MatheusNespolo/DataFlowInventory/docs/fluxogramas/Diagrama elétrico.pptx

Esteira A

TA

J1

MA

GND (0,5 mm)

D0_TA (0,5 mm)

VCC (0,5 mm)

PL_PASS_A

D0_TA

D0_J1

+

IRF520_A

VIN

GND

V+

V-

GND

VCC

SIG

GND (0,5 mm)

5V (0,5 mm)

Fonte 5V

VCC (0,5 mm)

GND (0,5 mm)

D0_TA – A0 (0,5 mm)

Arduino

A

B

RX

TX

D0_J1 (0,5 mm)

D0_J1 – A3 (0,5 mm)

GND

C

C

SIG_IRF520_A – 9 (0,5 mm)

ESP

TX2

RX2

GND

Esteira B

TB

J2

MB

VCC (0,5 mm)

PL_PASS_B

D0_TB

D0_J2

+

5V (0,5 mm)

Fonte 5V

Divisor de tensão

GND (0,5 mm)

D0_TB (0,5 mm)

VCC (0,5 mm)

GND (0,5 mm)

GND (0,5 mm)

D0_TB – A1 (0,5 mm)

D0_J2 – 2 (0,5 mm)

2KΩ

1KΩ

GND

D0_J2 (0,5 mm)

IRF520_B

VIN

GND

V+

V-

GND

VCC

SIG

SIG_IRF520_B – 10 (0,5 mm)

Esteira C

TC

J3

MC

PL_PASS_C

D0_TC

D0_J3

+

5V (0,5 mm)

Fonte 5V

GND (0,5 mm)

D0_TC (0,5 mm)

VCC (0,5 mm)

VCC (0,5 mm)

GND (0,5 mm)

GND (0,5 mm)

D0_TC – A2 (0,5 mm)

D0_J3 – 4 (0,5 mm)

D0_J3 (0,5 mm)

IRF520_C

VIN

GND

V+

V-

GND

VCC

SIG

SIG_IRF520_C – 11 (0,5 mm)

## Slide 2

Legenda

Sigla no esquema elétrico | Descrição/Identificação no sketch principal
TA, TB, TC | Sensor de início das esteiras / SENSOR_TOPO_{A..C}
J1, J2, J3 | Sensor final das esteiras / SENSOR_JUNCAO_J{1..3}
PL_PASS_{A..C} | Placa de conexão dos cabos para os periféricos das esteiras
IRF520_{A..C} | Módulo motor para controle de movimentação
Linhas vermelhas | Cabos de alimentação 5V (bitola de 0,5 mm)
Linhas pretas | Cabos de GND (bitola de 0,5 mm)
Linhas marrons | Sinais generalizados
Linhas laranjas | Comunicação serial
