MatheusNespolo/DataFlowInventory/img/prototipo/prototipo-montado-frente.jpg

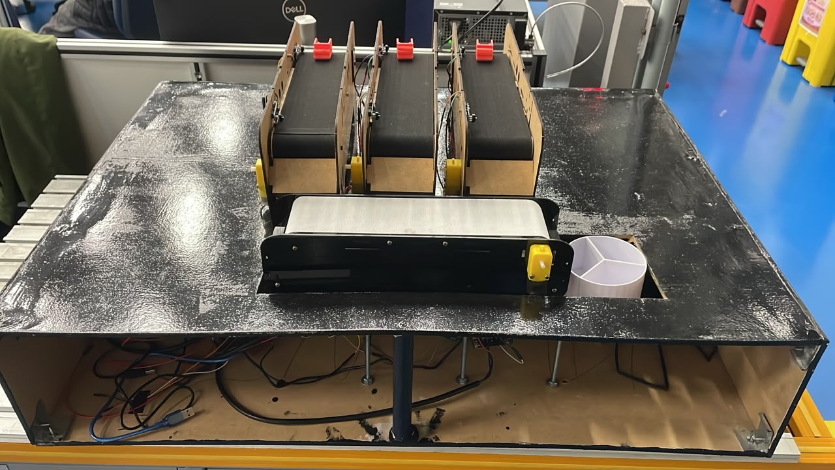
img/prototipo/prototipo-montado-frente.jpg
