MatheusNespolo/DataFlowInventory/img/prototipo/prototipo-montado-superior.jpg

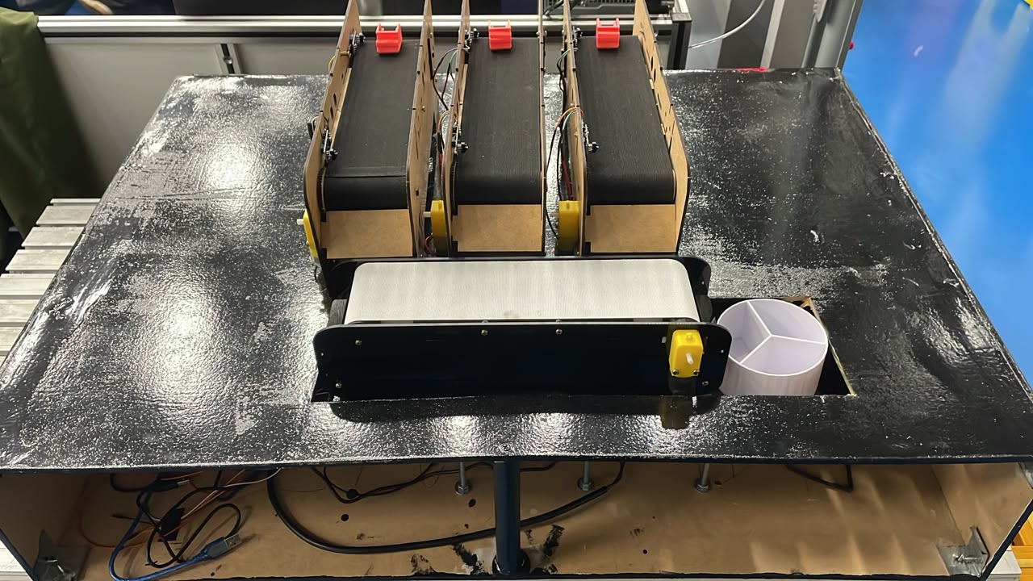
img/prototipo/prototipo-montado-superior.jpg
