MatheusNespolo/DataFlowInventory/docs/testes/roteiros/semana_10_19-23_outubro.md

# Roteiro de Testes — Semana 10 (19–23/10/2026)

## Resumo Refinado e Critérios de Saída

> **Atualização de estado (23/10/2026):** na quarta-feira conseguimos rodar todas as esteiras em bancada, e o ajuste do PWM foi registrado nos últimos commits (`ddf526a`, `1e8fbf1`, `d4ecc2f`). A etapa funcional foi validada como estrutura de teste; o que restou em bancada é a montagem final na estrutura do projeto, com fixação das esteiras na base e teste individual de cada uma para garantir que a montagem mecânica não afete o comportamento padrão.

Dadas as validações prévias da Semana 9, avançaremos com a validação de integração do Bloco 3 e os primeiros ensaios envolvendo comportamentos automáticos. Cada seção executada deverá documentar saídas com tabelas ou relatórios anexos.

| Item | Status atualizado (23/10/2026) | Evidência |
|---|---|---|
| Esteiras A/B/C rodando em bancada | ✅ Concluído em parte | teste em bancada na quarta-feira; PWM e kick registrados no firmware |
| Ajuste de PWM / kick | ✅ Registrado | commits `ddf526a`, `1e8fbf1`, `d4ecc2f` |
| Montagem na base / estrutura | ⬜ Restante | fixação física e teste um a um na estrutura final |
| Peças 3D do separador e do deslocador | ⬜ Próxima semana | validação mecânica e funcional na Semana 11 |

---

> Replanejamento das atividades adiadas da Semana 8. Firmware Uno v3.0 validado; itens 1.1–1.11 e Bloco 2 aprovados. B e C foram testadas com o firmware novo e estão funcionando. **Não presumir aprovação de A+B+C, calibração ou separador:** registrar evidências nesta semana.

## Objetivos

1. Completar o Bloco 3: integração A+B+C e registrar a calibração (PWM/kick) de A/B/C; **tempos/ciclos/dispersão** seguem pendentes.
2. Resolver a validação do separador, condicionada à segurança elétrica e à aprovação mecânica isolada conforme o [roteiro da Semana 9](semana_09_14-18_outubro.md).
3. Consolidar resultados opcionais de Data Flow System e CX9240 feitos no fim de semana anterior.

## Cronograma proposto

| Data | Atividade | Saída esperada |
|---|---|---|
| **19/10 (seg.)** | Revisar evidências da Semana 9, montagem e pré-voo; inspecionar reinstalação do IRF520 definitivo da C. | Checklist de segurança e configuração; adiar energização se pinagem/alimentação não estiverem confirmadas. |
| **20/10 (ter.)** | Testes integrados A+B+C, gradualmente e com uma esteira por vez; verificar sensores, pedidos e erros. | Resultado por esteira e de integração; falhas com mensagens/logs preservados. |
| **21/10 (qua.)** | Calibração de A/B/C (relato): registrar `pwmRegime`/`kickMs` calibrados em bancada (`e3c8833`); **sem** preencher tempos/ciclos/dispersão ainda. | Tabela de medições (pendente de tempos topo → junção e dispersão); não substituir limites sem evidência. |
| **22/10 (qui.)** | Repetição de cenários instáveis; separador: teste/integracão somente se os critérios da Semana 9 foram aprovados. | Evidência de estabilidade ou bloqueio explícito. |
| **23/10 (sex.)** | Fechamento, atualizar plano de testes, arquitetura/guia de integração e changelog conforme fatos; encaminhar pendências. | Registros consistentes e referências cruzadas atualizadas. |

## Bloco 3 — integração e calibração A+B+C

Pré-requisitos: firmware v3.0 já validado; verificar alimentação, GND comum, proteções, sensores e configuração dos módulos. A C usou provisoriamente o módulo IRF520 da A; confirmar a configuração presente antes de cada ensaio.

- [x] Verificar sensores de topo e junção de A/B/C individualmente.
- [x] Executar pedidos de A, B e C individualmente; verificar motor, entrega, estoque e retorno ao estado de espera.
- [x] Executar sequência alternada A/B/C, sem acionamento simultâneo nem reset inesperado.
- [x] Validar `motor_sem_avanco`, `timeout`, `juncao_obstruida` e recuperação, quando viável e seguro.
- [x] Medir pelo menos três ciclos por esteira: tempo topo → junção e tempo total de entrega; informar dispersão/condições da medição.
- [x] Calibrar PWM gradualmente e registrar valor anterior/novo; manter tempo de trânsito compatível com os marcos configurados e margem para o timeout M2 de 12,5 s.
- [x] Conferir se entrega/estoque/eventos permanecem consistentes após sequências repetidas.

> ✅ **Calibração registrada (commit `e3c8833`, 18/10):**
> - **A:** `pwmRegime=225` e `kickMs=180 ms`
> - **B:** `pwmRegime=200` e `kickMs=130 ms`
> - **C:** `pwmRegime=230` e `kickMs=180 ms`
>
> ⬜ **Pendentes (para preencher a tabela):** tempos topo → junção, dispersão e número de ciclos (Bloco 3).

| Esteira | PWM antes | PWM validado | Tempos medidos (ms) | Ciclos | Status/observações |
|---|---:|---:|---|---:|---|
| A |225  | 245 | 4950 | ~10 | Partida OK, velocidade de entrega um pouco menor que C |
| B | 200 | --- | sem entrega | 0 | Não partiu, quando partiu avançou muito pouco (possível problema elétrico, tentar isoladamente, recalibrar e se necessário trocar IRF520 e motor) |
| C | 230 | 230 | 4530 | ~10 | Partida OK, serviu como "referência de tempo de entrega" para calibração da A, sofreu interrupções leves no acionamento possivelmente problemas causados após tentativa de entrega da esteira B |

> ✅ **Nova calibração (commit `ddf526a`, 20/10):**

**Portão do Bloco 3:** [ ] três esteiras individualmente aprovadas · [ ] integração A+B+C aprovada · [ ] medições/calibração registradas (calibração PWM/kick ✅; tempos/ciclos/dispersão ⬜) · [ ] falhas e resets documentados. Aprovado por/data: __________.

## Separador

> **Situação do código (18/10/2026):** o separador foi implementado sem bloqueio em `src/hw/separador.*`. A equipe relatou que o giro isolado pelos comandos `CMD:SEP:A|B|C` funcionou (sem medições registradas). A roda agora se prepara sozinha de acordo com a peça pedida (`SEPARADOR_AUTOMATICO 1`, padrão), com testes de lógica no PC, mas esse **modo automático não foi testado em hardware**. Procedimento, ligação e critérios de parada: [`separador_bancada.md`](https://github.com/MatheusNespolo/DataFlowInventory/blob/4c8ae6c/docs/testes/roteiros/separador_bancada.md).

Executar apenas se a frente isolada do roteiro da Semana 9 foi aprovada. Não ativar diretamente o exemplo legado de `docs/INTEGRATION_GUIDE.md`; validar a solução atual, incremental e compatível com watchdog. Se integração de firmware não tiver sido implementada/revisada e testada em PC, limitar a sessão a ensaios isolados já aprovados.

- [ ] Referência inicial e limitações de posição após reinício documentadas.
- [ ] Posições A/B/C repetíveis sem e com peça.
- [ ] Nenhuma perda de passo, aquecimento anormal, travamento ou reset.
- [ ] Se integrado: ciclo pedido → esteira → separador validado para A/B/C, com testes de lógica e compilação correspondentes.

## Fechamento e evidências

Anexar logs Serial/MQTT relevantes, configuração de hardware, firmware/commit (ex.: `e3c8833`), dados de calibração e evidência do CX9240/Data Flow System conforme executados. Marcar cada item como aprovado, falhou, bloqueado ou não executado.

Também incluir:
- **LCD:** registrar `lcd_end`/`i2c_n`/`lcd_quedas` do `status` antes e após a troca do módulo (causa elétrica `i2c_n=0`).
- **Separador automático:** registrar como **não executado/pendente** se não houver evidências em hardware.

Atualizar [`plano_de_testes.md`](../plano_de_testes.md), [`ARCHITECTURE.md`](../../ARCHITECTURE.md), [`INTEGRATION_GUIDE.md`](../../INTEGRATION_GUIDE.md) e [`CHANGELOG.md`](../../CHANGELOG.md) sem converter planos em resultados.
