MatheusNespolo/DataFlowInventory/docs/testes/roteiros/firmware_uno_v3_validacao.md

# Roteiro — Validação em bancada do firmware do Uno v3.0

> Objetivo: confirmar na bancada o que os testes automatizados não alcançam (sensores, motores, alimentação). Execute na ordem; anote o resultado de cada passo. Firmware: `arduino/data_flow_inventory/` (v3.0). Desconecte o ESP32 dos pinos 0/1 durante o upload no Uno.

> **Execução:** este roteiro é a base dos blocos 1 a 3 do [roteiro da Semana 8](semana_08_05-09_outubro.md), que o aplica esteira por esteira (A, depois A+B, depois A+B+C), com aprovação a cada bloco.

Ferramentas: Serial Monitor (9600 baud) **ou** `test/mqtt_probe` (com o ESP32 conectado) e o dashboard.

> Abrir a Serial Monitor reinicia o Uno (auto-reset da USB) e o estoque volta a 15. Isso é esperado e aparece como `"reset":"reinicio"`.

## 1. Boot

1. Ligue o Uno.
2. **Esperado** (se o Uno já estava ligado e foi reiniciado pela USB, `reset` pode ser `"reinicio"`): a linha `{"type":"evento","evento":"inicio",...,"versao":"3.0",...,"reset":"energia","lcd":true|false,"ram_livre":N}`.
3. Anote `lcd` e `ram_livre`. Se `lcd` for `false`, leia a mensagem `"type":"status"` (sai a cada segundo) e use `lcd_end` e `i2c_n` para localizar o defeito:

| `i2c_n` | `lcd_end` | O que significa | O que fazer |
|---|---|---|---|
| `0` | `0` | Nada responde no barramento | Confira SDA=A4, SCL=A5 (sem inverter), solda dos 4 pinos do módulo, 5 V e GND. Quadrados pretos na 1ª linha com isso = display com energia, mas o módulo I²C não fala com o Uno |
| `1` ou mais | `0` | O barramento está vivo, mas o módulo de LCD não está em 0x20–0x27 nem 0x38–0x3F | O módulo pode ser de outro tipo: rode o scanner de `test/esteira_peca_a/arduino_teste_lcd` e anote o endereço |
| `1` ou mais | `39` (0x27), `63` (0x3F) ou outro | O LCD foi achado nesse endereço | Se o display continuar em branco, ajuste o contraste (trimpot) e o jumper do backlight |

   Se o LCD apagar depois de uma partida de motor, `lcd_quedas` sobe e o firmware tenta religá-lo sozinho em até alguns segundos, com o sistema parado: confira `lcd_end` voltando a um endereço e anote quantas quedas ocorreram por entrega (mais de uma por entrega indica ruído de motor: diodo 1N4007 nos motores, capacitor em paralelo, fios afastados do I²C).

## 2. Sensores (antes de qualquer entrega)

1. Com as três esteiras **vazias**, leia a mensagem `"type":"sensores"`: esperado `"juncao":{"J1":0,"J2":0,"J3":0}`.
2. Passe uma peça sobre cada sensor de junção, um por vez: o valor correspondente deve ir a 1.
3. Repita para os sensores de topo (`"topo"`), com e sem peça.
4. **Se algum sensor ficar sempre em 0 ou sempre em 1**, ajuste o potenciômetro do módulo TCRT5000 (ou a fiação) antes de seguir. Este passo resolve a causa provável da "entrega da B sem débito".

## 3. Uma entrega por esteira (A, B, C)

1. Coloque uma peça no topo da esteira e peça pelo dashboard.
2. **Esperado:** `pedido` → status `ACIONANDO_ESTEIRA` → esteira liga → `entrega` com o estoque daquela peça diminuído em 1 → cerca de 3 s depois da `entrega` a esteira para → status `AGUARDANDO_PEDIDO` (volta ~1,5 s depois).
3. Confira o débito no dashboard e no LCD.

## 4. Motor travado (esteira C)

1. Com uma peça no topo da esteira C (sem ela o erro seria `sem_peca_topo`), segure a esteira C com a mão (ou trave a peça no topo) e peça uma peça C.
2. **Esperado:** em ~3 s, `erro` com `"tipo":"motor_sem_avanco","fase":"partida"`, motor parado, estado `ERRO`, **sem reset do Uno** (nenhum novo `inicio`).
3. Envie Reiniciar no dashboard: volta a `AGUARDANDO_PEDIDO`.

## 5. Timeout no trânsito

1. Peça uma peça e, depois que ela sair do topo, retire-a da esteira antes da junção.
2. **Esperado:** em 12,5 s desde a partida, `erro` com `"tipo":"timeout","fase":"transito"`, motor parado, estoque **intacto**.

## 6. Peça presa na saída

1. Peça uma peça e, quando ela chegar à junção, segure-a sobre o sensor.
2. **Esperado:** `entrega` (débito feito) e, 3 s depois, `erro` com `"tipo":"peca_presa_saida","fase":"saida"`.

## 7. Junção obstruída

1. Com uma peça no topo da esteira, deixe outra peça parada sobre o sensor de junção e peça uma peça daquela esteira.
2. **Esperado:** `erro` com `"tipo":"juncao_obstruida","fase":"verificacao"`, **sem ligar o motor**. Sem peça no topo, o erro publicado é `sem_peca_topo` (a checagem prévia confere estoque, depois topo, depois junção).

## 8. Resistência

1. Faça 10 entregas seguidas (alternando A, B e C).
2. **Esperado:** nenhum `inicio` novo no meio (sem resets) e `ram_livre` do status estável.

## Registro

| Passo | Resultado | Observações |
|---|---|---|
| 1 Boot | | |
| 2 Sensores | | |
| 3 Entregas A/B/C | | |
| 4 Motor travado | | |
| 5 Timeout | | |
| 6 Peça presa | | |
| 7 Junção obstruída | | |
| 8 Resistência | | |
