MatheusNespolo/DataFlowInventory/test/firmware_uno/teste_protocolo.cpp

// Contrato do protocolo serial. As strings "esperado" reproduzem byte a
// byte o que o firmware v2.x (ArduinoJson) publicava: se um destes testes
// quebrar, o ESP32/servidor/dashboard podem deixar de entender o Uno.
#include "protocolo.h"
#include "teste.h"

static char buf[160];  // mesmo tamanho do buffer do firmware (src/hw/comunicacao.cpp)

// ---- Mensagens existentes (formato v2.x, sem campos novos) ----------------

TESTE(status_igual_v2) {
  formatarStatus(buf, sizeof buf, "AGUARDANDO_PEDIDO", 0, 42, -1);
  VERIFICA_TEXTO(buf, "{\"type\":\"status\",\"estado\":\"AGUARDANDO_PEDIDO\",\"pecaSolicitada\":0,\"uptime\":42}");
}

TESTE(estoque_igual_v2) {
  const int est[3] = {15, 14, 0};
  formatarEstoque(buf, sizeof buf, est);
  VERIFICA_TEXTO(buf, "{\"type\":\"estoque\",\"pecaA\":15,\"pecaB\":14,\"pecaC\":0}");
}

TESTE(sensores_igual_v2) {
  const bool topo[3] = {true, false, true};
  const bool jun[3] = {false, true, false};
  formatarSensores(buf, sizeof buf, topo, jun);
  VERIFICA_TEXTO(buf, "{\"type\":\"sensores\",\"topo\":{\"A\":1,\"B\":0,\"C\":1},\"juncao\":{\"J1\":0,\"J2\":1,\"J3\":0}}");
}

TESTE(esteiras_igual_v2) {
  const bool sec[3] = {false, true, false};
  formatarEsteiras(buf, sizeof buf, sec);
  VERIFICA_TEXTO(buf, "{\"type\":\"esteiras\",\"principal\":1,\"secA\":0,\"secB\":1,\"secC\":0}");
}

TESTE(pedido_igual_v2) {
  formatarPedido(buf, sizeof buf, 'B');
  VERIFICA_TEXTO(buf, "{\"type\":\"evento\",\"evento\":\"pedido\",\"peca\":\"B\"}");
}

TESTE(entrega_igual_v2) {
  const int est[3] = {15, 14, 15};
  formatarEntrega(buf, sizeof buf, 'B', est);
  VERIFICA_TEXTO(buf, "{\"type\":\"evento\",\"evento\":\"entrega\",\"peca\":\"B\",\"estoqueA\":15,\"estoqueB\":14,\"estoqueC\":15}");
}

TESTE(erro_igual_v2_com_e_sem_peca) {
  formatarErro(buf, sizeof buf, "ocupado", 'C', nullptr, -1, -1);
  VERIFICA_TEXTO(buf, "{\"type\":\"evento\",\"evento\":\"erro\",\"tipo\":\"ocupado\",\"peca\":\"C\"}");
  formatarErro(buf, sizeof buf, "peca_invalida", 0, nullptr, -1, -1);
  VERIFICA_TEXTO(buf, "{\"type\":\"evento\",\"evento\":\"erro\",\"tipo\":\"peca_invalida\"}");
}

TESTE(inicio_igual_v2_sem_campos_novos) {
  formatarInicio(buf, sizeof buf, "2.1", nullptr, -1, -1);
  VERIFICA_TEXTO(buf, "{\"type\":\"evento\",\"evento\":\"inicio\",\"msg\":\"Sistema iniciado\",\"versao\":\"2.1\",\"driver\":\"IRF520\"}");
}

// ---- Campos novos: sempre DEPOIS dos atuais e só quando informados ---------

TESTE(status_com_ram_livre) {
  formatarStatus(buf, sizeof buf, "ERRO", 2, 4294967295UL, 812);
  VERIFICA_TEXTO(buf, "{\"type\":\"status\",\"estado\":\"ERRO\",\"pecaSolicitada\":2,\"uptime\":4294967295,\"ram_livre\":812}");
}

TESTE(erro_com_diagnostico) {
  formatarErro(buf, sizeof buf, "timeout", 'B', "transito", 12503, 0);
  VERIFICA_TEXTO(buf, "{\"type\":\"evento\",\"evento\":\"erro\",\"tipo\":\"timeout\",\"peca\":\"B\",\"fase\":\"transito\",\"t_ms\":12503,\"bordas_juncao\":0}");
}

TESTE(inicio_com_campos_novos) {
  formatarInicio(buf, sizeof buf, "3.0", "watchdog", 0, 640);
  VERIFICA_TEXTO(buf, "{\"type\":\"evento\",\"evento\":\"inicio\",\"msg\":\"Sistema iniciado\",\"versao\":\"3.0\",\"driver\":\"IRF520\",\"reset\":\"watchdog\",\"lcd\":false,\"ram_livre\":640}");
}

TESTE(maiores_mensagens_cabem_no_buffer_de_160_bytes) {
  const bool t[3] = {true, true, true};
  VERIFICA(formatarSensores(buf, sizeof buf, t, t) > 0);
  VERIFICA(formatarErro(buf, sizeof buf, "peca_presa_saida", 'C', "transito", 2147483647L, 255) > 0);
  VERIFICA(formatarInicio(buf, sizeof buf, "3.0", "reinicio", 1, 2048) > 0);
  VERIFICA(strlen(buf) < 160);
}

TESTE(buffer_pequeno_devolve_zero_e_string_vazia) {
  char pequeno[10];
  VERIFICA(formatarPedido(pequeno, sizeof pequeno, 'A') == 0);
  VERIFICA_TEXTO(pequeno, "");
}

// ---- Comandos -------------------------------------------------------------------

TESTE(comandos_validos) {
  char p;
  VERIFICA(interpretarComando("CMD:PECA:A", &p) == CMD_PECA && p == 'A');
  VERIFICA(interpretarComando("CMD:PECA:C", &p) == CMD_PECA && p == 'C');
  VERIFICA(interpretarComando("  CMD:PECA:B \r", &p) == CMD_PECA && p == 'B');
  VERIFICA(interpretarComando("CMD:RESET", &p) == CMD_RESET && p == 0);
}

TESTE(comandos_invalidos) {
  char p;
  VERIFICA(interpretarComando("", &p) == CMD_NENHUM);
  VERIFICA(interpretarComando("   ", &p) == CMD_NENHUM);
  VERIFICA(interpretarComando("CMD:PECA:", &p) == CMD_PECA_INVALIDA);
  VERIFICA(interpretarComando("CMD:PECA:Z", &p) == CMD_PECA_INVALIDA && p == 0);
  VERIFICA(interpretarComando("CMD:PECA:AB", &p) == CMD_PECA_INVALIDA);
  VERIFICA(interpretarComando("CMD:PECA:a", &p) == CMD_PECA_INVALIDA);
  VERIFICA(interpretarComando("CMD:RESETX", &p) == CMD_DESCONHECIDO);
  VERIFICA(interpretarComando("{\"type\":\"x\"}", &p) == CMD_DESCONHECIDO);
}

TESTE(leitor_monta_linhas_e_ignora_cr) {
  LeitorLinha l;
  leitorIniciar(l);
  const char* entrada = "CMD:PE";
  for (const char* c = entrada; *c; c++) VERIFICA(!leitorAlimentar(l, *c));
  const char* resto = "CA:A\r\n";
  bool pronto = false;
  for (const char* c = resto; *c; c++) pronto = leitorAlimentar(l, *c);
  VERIFICA(pronto);
  VERIFICA_TEXTO(l.buf, "CMD:PECA:A");
}

TESTE(leitor_descarta_linha_longa_inteira) {
  LeitorLinha l;
  leitorIniciar(l);
  for (int i = 0; i < 50; i++) VERIFICA(!leitorAlimentar(l, 'x'));
  VERIFICA(!leitorAlimentar(l, '\n'));  // a linha longa some inteira
  const char* prox = "CMD:RESET\n";
  bool pronto = false;
  for (const char* c = prox; *c; c++) pronto = leitorAlimentar(l, *c);
  VERIFICA(pronto);
  VERIFICA_TEXTO(l.buf, "CMD:RESET");
}

// ---- Diagnóstico do LCD no status ----------------------------------------------

TESTE(status_com_diagnostico_do_lcd) {
  char buf[160];
  formatarStatus(buf, sizeof buf, "AGUARDANDO_PEDIDO", 0, 42, 1097, 39, 1, 0);
  VERIFICA_TEXTO(buf, "{\"type\":\"status\",\"estado\":\"AGUARDANDO_PEDIDO\",\"pecaSolicitada\":0,\"uptime\":42,\"ram_livre\":1097,\"lcd_end\":39,\"i2c_n\":1,\"lcd_quedas\":0}");
  // LCD fora: endereço 0 (campo presente), para o dashboard distinguir de "sem informação".
  formatarStatus(buf, sizeof buf, "ERRO", 2, 7, 900, 0, 0, 3);
  VERIFICA_TEXTO(buf, "{\"type\":\"status\",\"estado\":\"ERRO\",\"pecaSolicitada\":2,\"uptime\":7,\"ram_livre\":900,\"lcd_end\":0,\"i2c_n\":0,\"lcd_quedas\":3}");
}

TESTE(status_sem_campos_do_lcd_continua_igual) {
  char buf[160];
  formatarStatus(buf, sizeof buf, "ERRO", 2, 7, 900);  // chamada antiga: nada muda
  VERIFICA_TEXTO(buf, "{\"type\":\"status\",\"estado\":\"ERRO\",\"pecaSolicitada\":2,\"uptime\":7,\"ram_livre\":900}");
}

// O buffer do Uno tem 160 B e uma mensagem que estoura é DESCARTADA inteira (fim() devolve 0):
// o pior caso do status precisa caber com folga, e o ESP32 lê cada linha num
// StaticJsonDocument<512>.
TESTE(status_pior_caso_cabe_no_buffer_com_folga) {
  char buf[160];
  const size_t n = formatarStatus(buf, sizeof buf, "VERIFICANDO_ESTOQUE", 3, 4294967295UL, 2048, 127, 112, 65535);
  VERIFICA(n > 0);
  VERIFICA(n <= 150);  // folga de 10 B sobre o buffer de 160
}

// ---- Teste de bancada do separador (CMD:SEP, só pela USB) ------------------------

TESTE(comando_separador_aceita_compartimentos_e_neutro) {
  const char letras[] = {'A', 'B', 'C', '0'};
  for (int i = 0; i < 4; i++) {
    char linha[16] = "CMD:SEP:";
    linha[8] = letras[i];
    linha[9] = 0;
    char peca = 0;
    VERIFICA(interpretarComando(linha, &peca) == CMD_SEPARADOR);
    VERIFICA(peca == letras[i]);
  }
  char peca = 0;
  VERIFICA(interpretarComando("  CMD:SEP:B \r", &peca) == CMD_SEPARADOR);  // espaços nas pontas
  VERIFICA(peca == 'B');
}

TESTE(comando_separador_recusa_formas_invalidas) {
  char peca = 'x';
  VERIFICA(interpretarComando("CMD:SEP:Z", &peca) == CMD_DESCONHECIDO);
  VERIFICA(peca == 0);
  VERIFICA(interpretarComando("CMD:SEP:", &peca) == CMD_DESCONHECIDO);
  VERIFICA(interpretarComando("CMD:SEP:AB", &peca) == CMD_DESCONHECIDO);
  VERIFICA(interpretarComando("CMD:SEP:a", &peca) == CMD_DESCONHECIDO);   // minúscula não vale
  VERIFICA(interpretarComando("CMD:SEP", &peca) == CMD_DESCONHECIDO);
  // Os comandos que já existiam não mudam.
  VERIFICA(interpretarComando("CMD:PECA:A", &peca) == CMD_PECA);
  VERIFICA(interpretarComando("CMD:RESET", &peca) == CMD_RESET);
}
