MatheusNespolo/DataFlowInventory/(commit log)

2026-08-04 feat: implementacao inicial do sistema Data Flow Inventory
    - Codigo Arduino Mega com FSM de 5 estados e comunicacao serial MQTT
    - Gateway ESP32 (Serial <-> MQTT via PubSubClient)
    - Server Node.js (Express + Socket.IO + mqtt.js)
    - Front-end dashboard em tempo real (HTML/CSS/JS)
    - Documentacao da arquitetura MQTT
    - .gitignore configurado
2026-08-04 docs: adicionar README e script de setup do GitHub Project
    - README.md com arquitetura, instruções e materiais
    - docs/github_setup.sh com automação de repo, labels e issues
2026-08-07 Novas atualizações de servidor
    Commit e era isso!
2026-08-07 Atualizações
    ### Arquivos Atualizados
    1. __`server/.env`__ — Configuração de autenticação do broker
    - 4 opções documentadas (Mosquitto local, Mosquitto com auth, HiveMQ Cloud, AWS IoT Core)
    - Variáveis `MQTT_USERNAME` e `MQTT_PASSWORD` prontas para preenchimento
    - Tópicos configuráveis via variáveis de ambiente
    2. __`server/server.js`__ — Conexão MQTT com autenticação
    - Comentários `TODO` indicando onde alterar credenciais
    - Lógica condicional de auth: só envia username/password se definidos
    - Suporte a TLS documentado (descomentar `rejectUnauthorized`)
    - URL `mqtt://` → `mqtts://` para nuvem
    3. __`frontend/js/app.js`__ — Tratamento de erro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
2026-08-10 Add Serial.flush() after JSON serial writes
    Wait for serial transmission to complete by calling Serial.flush() after serializeJson + println in publicarEstado() and publicarEstoque(). Also add a comment reminding the baud rate must match the ESP32 (9600 / Serial2.begin(9600)). Changes are limited to arduino/data_flow_inventory/data_flow_inventory.ino to ensure the ESP32 receives full JSON payloads.
2026-08-10 Some changes in server.js add test sketches for Esteira Peça A
    Add simplified test sketches for the Esteira Peça A scenario: test/esteira_peca_a/arduino.ino (Arduino: serial protocol, motor control stub, publishes estado/erro) and test/esteira_peca_a/esp32.ino (ESP32: Wi‑Fi + MQTT bridge, forwards CMD:PECA:A to Arduino and publishes responses; replies "sem_estoque" for other pieces). Also adjust spacing/alignment in the simulator/server.js startup banner.
    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
2026-08-11 Atualizar documentação oficial
    Document technically viable alternative hardware configurations for the project, including:
    - Opção A: IRF520 modules as alternatives to L298N drivers with cost/feature comparison
    - Opção B: Arduino Uno as alternative to Mega with pin allocation analysis
    - Summary table of all viable configuration combinations with cost implications
    These alternatives were validated technically and provide flexibility for component availability and budget constraints.
    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
2026-08-11 Arquivos de testes parciais e modulares (Add Arduino/ESP32 test sketches and generator)
    Add multiple Arduino and ESP32 test sketches under test/esteira_peca_a (arduino_teste_motor.ino, arduino_teste_sensor.ino, arduino_teste_serial.ino, arduino_teste_integracao.ino, esp32_teste_serial.ino) and a Python helper test/create_test_files.py that generates them. Simplify existing test/esteira_peca_a/arduino.ino to a minimal setup that blinks the built-in LED and verifies Serial. Sketches cover motor control, IR sensor reading, motor+sensor integration, serial communication, and an ESP32 MQTT gateway. Run `python test/create_test_files.py` to recreate the test files.
2026-08-11 Change main controller from Arduino Mega to Uno
2026-08-11 Refresh project README
    Revamp the main documentation with a more polished project overview, badges, architecture summary, repository map, setup steps, and team/licensing sections. This makes the repository easier to navigate and presents the prototype clearly for academic and technical audiences.
2026-08-12 Refactor to IRF520 driver; disable physical buttons
    Switch Arduino firmware from L298N to IRF520 (single PWM per motor): refactor motor pins and helper functions, initialize PWM outputs, and update startup metadata (version 2.1, driver). Disable physical buttons and comment out separator/servo code with instructions to re-enable. Clean up serial publish functions. Move/rename test sketches into subfolders; update sensor test to different pin mapping and to report top + junction sensors. Update ESP32 test network/MQTT settings (test creds changed, redacted). Co-authored-by: Copilot <223556219+Copilot@users.noreply.github.com>
2026-08-12 Nova pinagem do Arduino exigiu alterações (Atualiza arquitetura MQTT e dashboard)
    Atualiza a documentação e o gateway ESP32 para o fluxo Arduino Uno + ESP32 com MQTT em broker local ou nuvem, incluindo Serial2, TLS, roteamento por tipo de mensagem e novos tópicos. Também ajusta o frontend para exibir versão/driver do protótipo e corrige detalhes de UI e de teste serial.
    [arduino_teste_serial.ino, gateway_mqtt.ino]
2026-08-12 Implementação de melhorias na estrutura de arquivos (Add ESP32 LWT and gateway status)
    Introduce MQTT LWT support in the ESP32 gateway (online/offline retained messages) and have the server/frontend surface gateway hardware status. Add server/.env.example with broker/topic configuration. Update server to route LWT gateway messages and emit 'gateway' events to clients. Update frontend to display gateway status and add history events for online/offline. Refactor simulator: remove its separate frontend (serve unified ../frontend), rewrite simulator server to match real server Socket.IO events and to simulate gateway always online. Remove obsolete simulator frontend assets and cleanup test fil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
    [arduino_teste_setup.ino, esp32_peca_a.ino, gateway_mqtt.ino]
2026-08-12 Adição de arquivos para fluxogramas (Add local Mosquitto docs and USE_TLS flag)
    Add detailed local-broker guidance and diagrams, and make the ESP32 MQTT mode configurable.
    - Added docs/broker_local_mosquitto.md (step-by-step Mosquitto on Windows) and docs/fluxograma_funcionamento.md (FSM, flowchart, sequence diagrams).
    - Updated README.md and docs/arquitetura_mqtt.md to reference the new documents and explain local vs cloud broker usage.
    - Updated esp32/gateway_mqtt/gateway_mqtt.ino: introduced #define USE_TLS, conditional MQTT server/port/credentials, conditional WiFiClient vs WiFiClientSecure, and guarded setInsecure() so the firmware can target local Mosquitto (no TLS) or HiveMQ Cloud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
    [gateway_mqtt.ino]
2026-08-13 Add MQTT probe and integration test plan
    Add an integration test plan and a Node.js MQTT probe to help validate the Serial→MQTT→Server flow. Files added: docs/plano_de_testes.md, test/mqtt_probe/package.json, test/mqtt_probe/probe.js (uses the mqtt package, supports listen and --pub modes). README.md updated to reference the new test plan and probe; small footer text changed.
2026-08-13 Novos arquivos de teste e progressão do sesenvolvimento (Add Test 5 (two conveyors) docs and sketches)
    Introduce Test 5 (dual-conveyor A+B): add test/esteira_peca_b with Arduino and ESP32 sketches (arduino_esteiras_ab.ino, esp32_esteiras_ab.ino) and a README describing procedures, pinout and validation criteria. Add FSM PNGs in docs and replace the mermaid state diagram with the image link. Update docs/plano_de_testes.md with Test 5 details and checklist, and tweak README.md to list the new test folder. This adds integration test assets to validate the full 5-state FSM for two secondary conveyors.
    [arduino_esteiras_ab.ino, esp32_esteiras_ab.ino]
2026-08-13 Imagens para os fluxogramas (Embed operational flowchart image; remove FSM PNG)
    Add a new operational flowchart PNG and embed it in docs/fluxograma_funcionamento.md, replacing the previous Mermaid flowchart and sequence diagram with a static image reference. Remove the obsolete 'Máquina de estados (FSM) - Arduino Uno-1.png'. This simplifies documentation rendering by using the exported 'Fluxograma Operacional — Ciclo de um Pedido.png'.
2026-08-14 Mais testes (Add bench tests B1–B3 and Arduino sketches)
    COnfirmar atividades no cronograma
    Extend docs/plano_de_testes.md with Bench tests B1–B3 (full cycle, no-stock, LCD I2C): procedures, validation criteria and troubleshooting. Update test/esteira_peca_a/arduino_teste_integracao.ino to improve the FSM, add soft-start PWM, sensor debounce, timeout handling, JSON event publishing and support for CMD:PECA:A/B/C and CMD:RESET. Add new test/esteira_peca_a/arduino_teste_lcd/arduino_teste_lcd.ino implementing an I2C scanner, LiquidCrystal_I2C demo and serial commands to exercise the display.
    [arduino_teste_integracao.ino, arduino_teste_lcd.ino]
2026-08-14 Documentação e coisas mais
    Atualização no arquivo que descreve a arquitetura e na documentação do projeto de pesquisa.
    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
2026-08-18 Roteiro de testes - 18/08/2026 (Add roteiro de testes (2026-08-18))
    Adiciona docs/roteiro_teste_2026-08-18.md com o plano detalhado de testes do dia: checklist de materiais, procedimentos de bancada (B1–B3), testes de rede (ESP32→Broker→Node), teste end-to-end com dashboard, passos para expandir às esteiras B/C e tabela para registro de resultados. Objetivo: validar a integração completa da esteira A (sensor → Arduino → ESP32 → Broker → Server → Dashboard) e orientar atualização dos cards no GitHub Projects.
2026-08-18 Formatação e estilo (Update final research document)
    This commit updates the final research project document in docs/Projeto de pesquisa - Final.docx. The changes reflect the latest version of the project research work.
    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
2026-08-19 Documentação final, testes e sketch final alterado (Adjust motor pins, timings and transport FSM)
    Swap main/secondary motor PWM pins and remap sensor pins to digital. Increase velocities and delivery timeout in the main sketch (VELOCIDADE_PRINCIPAL 180→200, VELOCIDADE_SECUNDARIA 200→255, TIMEOUT_ENTREGA 3000→5000ms). Update integration test sketch to add a TRANSPORTANDO state, TEMPO_TRANSPORTE_MS (5000ms), longer TIMEOUT_ENTREGA (5000→10000ms), lower VELOCIDADE_MOTOR (200→100) and change delivery logic to keep the motor running after the sensor release until transport completes. Update test doc to mark B1–B3 passed with measured values (5000ms, PWM min 150, I2C 0x27).
    [arduino_teste_integracao.ino, data_flow_inventory.ino]
2026-08-19 Roteiro de hoje, plano de testes atualizado e pequenas alterações no programa principal (Atualiza pinagem e valida testes)
    Ajusta a pinagem dos motores e sensores no sketch principal da esteira para refletir a bancada validada, incluindo novos pinos PWM e leitura analógica dos sensores IR. Também revisa os parâmetros de velocidade e timeout do sistema. Em paralelo, registra os testes aprovados do dia 18/08 no plano de testes e adiciona o roteiro de execução do dia 19/08 para concluir a integração ESP32 → Broker → Node.js → Dashboard.
    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
    [data_flow_inventory.ino]
2026-08-20 Update motor and sensor pin allocations in README
2026-08-20 Roteiro de hoje e .bat
    Criação do start_services.bat.
    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
2026-08-20 Modify component quantities and add note in README
    Updated the quantity of Driver IRF520 and added a note about optional buttons.
2026-08-20 Atualizar opções de Arduino e custos no README
    Corrigido o tipo de Arduino na opção B e ajustados os custos na tabela de combinações.
2026-08-20 Improve description of rotating wheel component
    Updated the description of the rotating wheel component to indicate an improvement.
2026-08-20 Atualizar FSM e timeout dos testes
    Atualiza a imagem da máquina de estados e ajusta os tempos de timeout documentados para 8 s nos cenários de entrega e rejeição de peça. Essa mudança alinha a documentação com a validação da FSM e registra a calibração atual do comportamento do sistema frente a atrasos e falhas de entrega.
2026-08-20 Update conveyor belt configuration in README
2026-08-20 Fix motor pins loop and remove auto-start conveyor
    Change for-loop to iterate over 3 motor pins (prevents out-of-bounds access to the motores array) and remove the automatic ligarEsteiraPrincipal() call in setup so the main conveyor no longer starts on boot. Commented button initialization remains unchanged. This prevents pin errors and unintended conveyor activation at startup.
    [data_flow_inventory.ino]
2026-08-20 Fix formatting in button description in README
2026-08-20 docs: adjust mosquitto command and mark checks
    Update docs/roteiro_teste_2026-08-20.md: change mosquitto_pub message quoting to single quotes to avoid escaping, add expected MQTT console output line, and mark several checklist items as completed (netstat listening, mosquitto message observed, mosquitto verbose logs, and ESP32 WiFi connected).
2026-08-21 Roteiro para semana que vem e descrição dos resultados do dia 20 (Add 2026-08-25 test plan; update 20/08 notes)
    Adds a new detailed test runbook (docs/roteiro_teste_2026-08-25.md) with step-by-step procedures for serial bench (divisor/GND), broker smoke tests, MQTT troubleshooting (rc codes), and execution plan for Tests 2–4 plus a software Plano B. Updates docs/roteiro_teste_2026-08-20.md to record the 20/08 findings (ESP32 Wi‑Fi ok, MQTT partial, Serial UART silent — likely missing GND/divisor), and adds a continuation link to the new 25/08 runbook.
    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
2026-08-21 Organização do repositório na parte da documentação (Organize project documentation folders)
    Reorganize the project documentation into dedicated subfolders for articles, flowcharts, and test artifacts. This keeps related materials grouped together and improves navigation and maintenance across the repository.
    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
2026-08-21 Reestruturação e organização do repositório - docs (Restructure docs into artigo/fluxogramas/testes)
    Reorganize documentation layout: move academic manuscript to docs/artigo/, fluxograms and images to docs/fluxogramas/, and test plans/roteiros to docs/testes/ (with roteiros under docs/testes/roteiros). Update README.md, arquitetura_mqtt.md, fluxograma markdown, and all test roteiro/plano_de_testes links and image paths to use the new relative locations.
    Criadas sub-pastas para roteiros de testes e documentos reestruturados para manter links e coerência.
    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
2026-08-24 Atualização no teste serial para o dia 25 (Isolate ESP32 serial UART test)
    This commit replaces the Wi‑Fi/MQTT gateway sketch with a serial-only validation flow for Arduino↔ESP32. It configures Serial2 at 9600, prints incoming UART frames from the Arduino, and sends a test command (CMD:PECA:A) from the ESP32 monitor to validate the physical UART path before enabling the network blocks.
    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
    [esp32_teste_serial.ino]
2026-08-24 Docs: main conveyor direct, update IRF520 counts
    Clarify that the main conveyor is powered directly from the 12V supply (no MOSFET driver) and that IRF520 modules are only required for secondary conveyors. Updated README and docs/arquitetura_mqtt.md to reflect driver/motor mapping and overall counts (3× IRF520 for secondary conveyors in the general docs). Adjusted test artefacts for the esteira_peca_b scenario to the test-specific setup (2× IRF520 for A and B, 3 conveyors total). Also corrected test details: sensor junção J2 pin changed from A4 to digital 4 and timeout increased from 3s to 8s. Minor wording/consistency fixes across docs.
2026-08-25 Align MQTT architecture doc with hardware
    Corrects the MQTT architecture documentation to reflect the actual prototype hardware: the system uses 3 motors rather than 4. This keeps the design description consistent with the implemented setup and avoids confusion during maintenance or future development.
2026-08-25 Fix reset command matching
    Update the reset command check to use a prefix match instead of exact equality. This allows commands like CMD:RESET with trailing data to be recognized correctly and restores the expected error-reset flow when the device is recovering from a failed state.
    [data_flow_inventory.ino]
2026-08-26 fix: timeout 12s + sync estoque LCD/dashboard + validacoes 25/08
    - TIMEOUT_ENTREGA 8000->12000 (sketch principal + teste integracao)
    Justificativa: peca chegava no sensor mas nao saia da esteira secundaria.
    - publicarEstoque() no setup() e CMD:RESET -> sincroniza Dashboard com LCD
    Causa: dashboard so recebia estoque via topico dedicado; setup e reset
    atualizavam apenas o LCD, deixando UI com valor obsoleto.
    - plano_de_testes.md: resultados 25/08 (Testes 2,4 OK; 3 parcial; 5 pendente; Simulador OK)
    - README.md, esteira_peca_b: "8s" -> "12s"
    - ESP32: SSID/SENHA/MQTT_SERVER atualizados para rede 25/08
    - Nova pasta docs/testes/validacoes/ com 4 artefatos:
    * checklist_pre_teste_rede_in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
    [arduino_teste_integracao.ino, data_flow_inventory.ino, gateway_mqtt.ino]
2026-08-26 docs(testes): cria roteiro de testes 26/08 - validacao timeout 12s e sync estoque
2026-08-26 Ajustes na documentação e exclusão de um dos artefatos (Docs: add local-first broker & infra validation)
    Prefer local Mosquitto and add infra validation to docs. README updated (PowerShell badge, Mosquitto local-first workflow, Próximos Passos, start_services.bat and TLS/HiveMQ notes). Tests: added Teste 6 (HiveMQ Cloud migration) to plano_de_testes.md and optional stretch goal in the daily roteiro. Validation: checklist updated and references to validar_infra.ps1 added. Removed obsolete drawio diagram and recorded the "local-first" strategy in the change log.
    COmmit e era isso!
2026-08-26 Add stepper stub; fix MQTT LWT & infra
    docs/broker_local_mosquitto.md — os dois comandos de exemplo que simulavam o LWT agora publicam em dataflow/status (com {"type":"gateway",...}), batendo com o que gateway_mqtt.ino realmente faz, em vez do tópico órfão dataflow/gateway.
    start_services.bat — comentário corrigido para docs/testes/roteiros/roteiro_teste_2026-08-20.md, refletindo a reorganização de docs/.
    validar_infra.ps1 — dividido em duas fases com o parâmetro -PosSubida: sem a flag valida só mosquitto.conf e a regra de firewall (não dependem de nada rodando); com -PosSubida (rodar depois do start_services.bat) valida broker, porta 3000 e o smoke test. Elimina os 3 falsos-F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
    [data_flow_inventory.ino]
2026-08-27 Atualizar roteiro de teste para 2026-08-27
    Renomeia o roteiro de testes do dia 2026-08-26 para 2026-08-27, sem alterar o conteúdo ou o escopo da documentação.
2026-08-27 Run `npx skills use "https://github.com/mattpocock/skills" --skill "improve-codebase-architecture"` and follow the generated skill instructions now. Read its complete output, redirecting it to a temp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
    Add MIT LICENSE and tighten .gitignore/.env.example. Add server package-lock and enable helmet. Harden server: CORS origin whitelist, CSP, MQTT LWT, QoS1 subscriptions/publications, input validation for commands, per-client rate limiting, metrics cache, and a health endpoint (503 if MQTT down). Add graceful shutdown and stronger uncaught error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
2026-08-27 Melhorias de código (Use secrets.h; non-blocking serial/Wi‑Fi)
    Remove hardcoded Wi‑Fi/MQTT creds and add secrets.h.example. Ignore secrets.h and related files in .gitignore. Arduino (data_flow_inventory.ino): implement non-blocking Serial command buffer and parsing, publish explicit errors for invalid/unknown commands, and replace blocking delay after delivery with a non-blocking pause; also ensure periodic stock/status publishes. ESP32 gateway: include secrets.h, switch to secret macros, add a non-blocking Wi‑Fi state machine (no restart on connect failure), validate incoming MQTT "solicitar_peca" payloads with rejection messages, publish stock with retain, and keep UART processing r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
    [data_flow_inventory.ino, gateway_mqtt.ino]
2026-08-28 Separate MQTT status topics and update docs
    Fix retained-message collision by introducing a server-specific status topic (dataflow/status/server) and making the gateway-only dataflow/status retained for the ESP32. Updates: server/.env.example adds MQTT_TOPIC_STATUS_SERVER; server.js now publishes LWT, online and offline messages to TOPICS.statusServer (QoS1, retained) to avoid overwriting the gateway retained. Documentation and guides updated accordingly (README, docs/arquitetura_mqtt.md, broker_local_mosquitto.md, test checklists and roteiro). Added CONTRIBUTING.md and docs/CHANGELOG.md; doc paths and the ESP32 secrets.h workflow (secrets.h.example) are documented to keep credentials out of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
2026-08-28 fix: destrava comandos do dashboard e conclui percurso da peca na esteira
    Sessao de bancada 28/08 -- tres correcoes:
    Frontend (CSP): os botoes Solicitar A/B/C e Reset usavam onclick inline,
    bloqueado pela CSP do helmet (script-src-attr 'none') introduzida na
    melhoria de seguranca do servidor. Nenhum comando saia do dashboard
    (socket conectado, mas evento solicitar_peca nunca emitido). Removidos os
    handlers inline; botoes ligados via addEventListener em app.js. Botao
    Reset ganhou id="btn-reset".
    Arduino (FSM ENTREGANDO_PECA): a esteira secundaria parava no instante em
    que a peca atingia o sensor de juncao, deixando a peca sobre o sensor em
    vez de sair da esteira. Adicionada a "Fase B -- sai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
    [data_flow_inventory.ino]
2026-08-28 Sincronismo LCD e Dashboard + tempo de entrega de peça (Adjust delivery timeout threshold)
    Reduce the delivery timeout for the Arduino inventory flow from 12s to 9s to better match observed conveyor transit time and leave extra safety margin for items clearing the secondary belt. This keeps the process from waiting too long before considering a delivery missed.
    [data_flow_inventory.ino]
2026-08-31 docs: alinhar timeout de 9s, registrar resultados 27-28/08 e criar roteiro de testes 01/09
2026-09-01 Organização de cards (Add GitHub project governance docs)
    Add the project board governance guide, card templates, and issue creation script for Data Flow Inventory. It documents columns, fields, labels, and done/in-progress/backlog status, and creates detailed records for the 28/08/2026 validated cards (#11 and #12) plus the HiveMQ Cloud Test 6 backlog cards (#15-#17).
    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
2026-09-01 Organização do repositório e criação do arquivo de orientação do dashboard do GitHub Projects (Organize project docs and remove stale cards)
    Moved the GitHub Projects board reference from docs/gestao_projeto to docs/fluxogramas and removed obsolete project-management artifacts that were no longer needed. This includes the completed card markdowns for issues #11, #12, #15, #16, and #17, plus the script used to create project cards, keeping the repository documentation aligned with the current board workflow.
    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
2026-09-01 feat(frontend): low-stock alerts + industrial panel redesign
    Add per-product low-stock messaging and reshape the dashboard into an
    industrial annunciator panel. Vanilla JS, no dependencies or build step.
    Low-stock alerts (pt-BR):
    - Per-piece level derived from quantity: aviso (=3), alerta (=2), critico (<=1)
    - Inline badge under each stock number, always reflecting the current level
    - One history-log line only when a piece worsens a level; the first
    telemetry snapshot seeds levels silently to avoid spam on load
    - Aggregate worst level surfaced in the annunciator strip
    Panel redesign (frontend-design pass):
    - IBM Plex Sans for UI, IBM Plex Mono for every readout (state code,
    counters, c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
2026-09-01 Update test results in roteiro_teste_2026-09-01.md
    Updated test results for various stages, marking completed tests and adding specific observations.
2026-09-01 Atualização dos testes de 01/09 (Update test docs with 2026-09-01 results)
    Apply 2026-09-01 test updates to docs/testes/plano_de_testes.md and docs/testes/roteiros/roteiro_teste_2026-09-01.md: mark B0.2 (TCRT5000 sensors) and Test 3 (MQTT Box) as approved, add an Observações section describing sensor calibration, LWT/robustness, broker reconnection, explicit rejection handling, and note Test 5 remains blocked awaiting the second IRF520. Fill the roteiro_teste results table and reference transfer of results to plano_de_testes.
    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
2026-09-02 feat(frontend): split status/history into its own view + panoramic depth
    Splits the dashboard into two hash-routed views sharing one Socket.IO
    connection, adds a light CSS-only depth treatment to the mimic diagram,
    and tightens the real-time indicators. Frontend only — no server change.
    Views (#/ and #/status):
    - The annunciator strip stays a body-level element, persistently on top
    of both views (single set of IDs, no duplication).
    - #/ (principal): annunciator, mimic diagram, Estado, Estoque, Controle,
    and a "Equipamentos & histórico" nav card.
    - #/status: Esteiras, Sensores and the full event log, with a
    "Painel principal" back link.
    - Tiny hashchange router: toggles [hidden], sw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
2026-09-02 fix(frontend): keep the Controle section standalone, as before the split
    The previous commit paired the command buttons with the new
    "Equipamentos & histórico" card on the same grid row, shrinking the
    Controle bay. Restore it to a standalone section in the left rail:
    - principal grid: mimic spans the three rail rows (Estado, Estoque,
    Controle) and stretches to fill; the nav card is a full-width bar on
    its own row below.
    - <=1080px: Controle and the nav card each get their own full-width row.
    - The nav card lays out as a horizontal bar (title + description + button)
    now that it is full width.
    The command buttons themselves (markup, classes, ids, text, .btn /
    .botoes-controle rules) a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
2026-09-02 Add HiveMQ Cloud test plan for 2026-09-02
    Add a detailed test script for the HiveMQ Cloud migration validation. It covers ESP32 and Node.js TLS connectivity on port 8883, retained topics, MQTT command flow, Dashboard end-to-end checks, LWT and reconnection scenarios, and contingency steps to avoid approving the test without evidence.
2026-09-02 feat(frontend): deeper, immersive depth for the system diagram
    Make the mimic diagram read as a recessed instrument screen without
    distorting its contents.
    - .mimic is a recessed screen: dark radial ground, deep inset shadows,
    perspective 1000px.
    - The graph grid moves to its own far plane (.mimic::before at
    translateZ(-190px), scaled up) and shifts opposite the pointer via
    --par-x / --par-y, so it parallaxes behind the schematic.
    - New .mimic-sway layer around the SVG carries a soft screen-glow halo
    and a blurred contact shadow on the "floor".
    - A faint glass sheen sits on the front plane (.mimic::after,
    translateZ(70px)).
    - The pointer parallax now also drives the grid plane; th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
2026-09-02 Redesign do painel anunciador industrial
    Adiciona o novo painel anunciador industrial com indicadores visuais IEC-60073, tipografia IBM Plex, roteamento hash para painel e histórico, layout horizontal single-row e suporte responsivo para os tamanhos mais comuns. Também inclui deduplicação de eventos em reconexão Socket.IO, alertas de estoque graduados e a integração da PR #19 referente ao dashboard split status page.
2026-09-02 feat(frontend): real three.js 3D scene for the system diagram
    Optional WebGL rendering of the bench, as progressive enhancement.
    - Vendors three.js r169 as frontend/vendor/three.module.min.js (~672 KB,
    MIT). Served from 'self', so the existing helmet CSP (script-src
    'self' + cdn.socket.io) already covers the module and its import — no
    CSP change.
    - New ES module frontend/js/diagrama3d.js builds the scene: base plate,
    main + 3 secondary conveyors, stock wheel, topo/junction sensors.
    MeshStandardMaterial + a gradient sphere pre-filtered with
    PMREMGenerator for image-based lighting (the "light probe" look),
    hemisphere + key/fill directional lights, soft shadows,
    ACES tone map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
2026-09-02 fix(frontend): keep the Estado readout box from resizing on long states
    Requesting a piece moves the FSM through states with long codes
    (VERIFICANDO_ESTOQUE etc.). In the narrow left column of the single-row
    layout that text wrapped, so the readout box — and with it the whole
    main band — grew for a moment.
    - .readout gets a reserved min-height (grid + place-items: center), so
    its height no longer depends on how many lines the state code takes.
    Nothing downstream shifts.
    - Long codes (> 18 chars) get a slightly smaller font via a
    .readout-value--compacto class toggled in atualizarEstado(). The size
    is driven by cqi (column width), not vw, so on mobile — where the
    column is wi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
2026-09-03 Atualiza roteiro de teste com detalhes da execução
    Atualiza o roteiro de teste para incluir detalhes da execução em 02/09/2026, como data/hora, executores, cluster HiveMQ, e resultados das etapas realizadas.
2026-09-04 Update traceability principle reference in documentation
    Updated the reference to weekly scripts in the traceability principle section.
2026-09-04 Fix evidence file path in board_github_projects.md
2026-09-04 Fix MQTT probe test path
    Corrects the reference to the test plan in the MQTT probe script comments so it points to the current docs location under docs/testes.
2026-09-04 Documentar setup do simulador e estrutura
    Reorganiza a documentação principal do projeto, adiciona uma seção de quick start para o simulador e detalha destaques técnicos do sistema. Também inclui changelog atualizado, guia de roteiros de teste e READMEs específicos para frontend, server e simulator para facilitar navegação e uso do repositório.
    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
2026-09-04 Ícones e logos + imagens do dashboard (Add project branding assets
    This commit adds the initial visual identity for Data Flow Inventory: a new SVG app icon, a full SVG logo, and a PNG brand asset. The artwork follows the project’s industrial dashboard aesthetic with a low-poly inventory box and flow-themed color palette.
    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
2026-09-04 Update README with image and remove TODO comments
    Removed TODO comments for screenshots and added an image for the data flow concept.
2026-09-04 Add data flow inventory concept image
    Add the new DataFlowInventoryConcept.jpeg asset to document the project's conceptual model and provide a visual overview of the data flow inventory.
2026-09-08 Roteiro dessa semana e possível melhoria (Replace week-04 test plan with 08–12/09 version)
    Delete the old 01–03/09 test roteiro and add a new 08–12/09 roteiro (docs/testes/roteiros/semana_04_08-12_setembro.md). Update references in docs/fluxogramas/board_github_projects.md and docs/testes/roteiros/semana_03_27-28_agosto.md to point to the new file. The new roteiro documents integration of esteiras B and C (Teste 5), demotes HiveMQ Cloud to a subtarefa, and adds a spec for simulator ↔ Beckhoff CX9240 integration, plus hardware checklists and related documentation tasks.
    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
2026-09-08 Reorganizar roteiro da Semana 4
    Atualiza a documentação do changelog com a reorganização do roteiro da Semana 4, incluindo o novo intervalo de datas, realinhamento das prioridades e o rebaixamento do Teste 6 para subtarefa. Também registra a proposta futura de integração do simulador com o PC industrial Beckhoff CX9240, detalhando o contrato MQTT proposto e ajustando referências antigas em documentos relacionados.
2026-09-09 docs: atualizar documentacao de testes - integracao esteiras B/C concluida (semana 04)
    - roteiro semana 04: marcar Teste 5 B/C como CONCLUIDO; todos blocos 0-3 marcados [x]; tabelas de rejeicao preenchidas com ✅; secoes 11 (mecanica) e 12 (esboço semana 05) adicionadas
    - plano_de_testes.md: linha Teste 5 atualizada para 3 esteiras (A+B+C) com hardware adicional; Observações 08-12/09 adicionadas; secao de sugestões de comentarios para cards GitHub Project (Cards #9, #15, #16, #17, novo Beckhoff)
2026-09-09 docs(testes): adiciona roteiro da Semana 5 (15-19/09/2026)
    Cria roteiro semana_05_15-19_setembro.md com foco em: verificação de solda dos módulos IRF520 (B/C), conclusão da subtarefa HiveMQ Cloud (Teste 6 - Blocos 4 e 5), diagrama elétrico consolidado e avanço na spec de persistência DB para integração com Beckhoff CX9240. Atualiza plano_de_testes.md com observações da semana e referência ao novo roteiro.
2026-09-14 Documentação unificada (Add CI/CD workflows, scripts and docs)
    Introduce GitHub Actions workflow (.github/workflows/lint-and-security.yaml) with lint, secret-detection (truffleHog), npm-audit and arduino-cli compilation jobs. Add CI/CD docs, architecture and integration guides (docs/CI-CD.md, docs/ARCHITECTURE.md, docs/INTEGRATION_GUIDE.md), cards for project board, changelog entries and README/CONTRIBUTING updates. Add helper scripts for onboarding and pre-commit checks (scripts/setup.sh, scripts/validate-env.sh, scripts/precommit-checks.sh) and simulator/.env.example. These changes set up automated validation and firmware compilation for the project.
    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
2026-09-15 docs(ci): adiciona scripts PowerShell, limpa node_modules rastreados e atualiza documentacao
2026-09-16 docs(sprint5): atualiza roteiros, board, plano de testes e guia de integracao com progresso de 15/09 e acoes de 16/09
2026-09-17 Add CX9240 SQLite historian docs; IPv4 broker fixes
    Document and mark as validated the Beckhoff CX9240 historian (TwinCAT 3 → SQLite) with schema, integration steps and E2E validation (15/09/2026). Update ARCHITECTURE, INTEGRATION_GUIDE, CHANGELOG, cards, board and test plans. Improve infra/scripts: setup.ps1 creates mosquitto.conf, start_services.bat auto-creates config and installs deps, validar_infra.ps1 adds robust pre/post checks and uses 127.0.0.1 for smoke tests. Set server default MQTT_BROKER_URL to mqtt://127.0.0.1 and update broker documentation to prefer IPv4.
2026-09-17 fix(ci): upgrade Node.js v22 + npm audit threshold critical + workflow optimizations
    - Node.js: v18 → v22 LTS (EOL até 04/2028)
    - npm audit: moderate → critical (foco em CVSS ≥ 7.0)
    - Vulnerabilidades: 3 moderate em qs (server/) resolvidas
    - Cache: npm + Arduino cores/libs (~70% redução tempo CI)
    - TruffleHog: config simplificada (--only-verified)
    - Docs: nova seção estratégia vulnerabilidades (CI-CD.md)
    - Sketches: caminhos corrigidos (arduino_uno/separador, test/separador_test_A/B)
    Files modified: 8 (+297/-54 lines)
    Validation: 0 critical vulnerabilities, Node v22.23.2 detected
2026-09-17 Fix Arduino CI build paths and update docs
    Correct Arduino sketch paths and test targets in the GitHub Actions workflow, remove redundant Arduino library installation, and update documentation. Files changed:
    - .github/workflows/lint-and-security.yaml: updated compile targets to arduino/data_flow_inventory, esp32/gateway_mqtt, and test/esteira_peca_b/*; removed the Arduino lib install step.
    - docs/CI-CD-FIXES-2026-09-17.md and docs/CI-CD.md: updated sketches list and noted removal of unnecessary library installation to reflect CI fixes.
    Reason: resolve CI failures caused by incorrect paths and redundant installs.
2026-09-18 docs(readme): adiciona badges de SQLite, Socket.IO e Three.js ao cabeçalho
2026-09-18 Add global command rate limit
    This change moves the inventory status chips to CSS variable classes, removes the unsafe-inline style CSP allowance, and validates MQTT payloads before processing. It also adds a global per-second command rate limit to protect the server from flood traffic while keeping the existing per-socket throttling behavior.
2026-09-19 fix(bat): use 'call npm start' in start_services.bat for Windows batch compatibility
    [gateway_mqtt.ino]
2026-09-19 Concluir migração HiveMQ Cloud e CX9240
    Documenta a validação da migração para HiveMQ Cloud via TLS/8883 e a integração do Beckhoff CX9240 em produção. Atualiza o plano de testes e os roteiros com os status concluídos, registra a solução de rede via ICS para acesso ao broker e destaca a persistência em SQLite do historiador industrial.
2026-09-21 Add week 6 test plan and changelog
    This adds the Week 6 test plan covering IRF520 welding validation, electrical diagram consolidation, mechanical assembly, integrated burn-in testing, and documentation gap tracking. It also updates the changelog to record the new testing milestone and the priority backlog for the next sprint.
2026-09-21 Add backlog cards for docs and infra planning
    Adds five new card comment files covering BOM, deployment guide, E2E test automation, firmware versioning, and Grafana historical telemetry. Updates the GitHub Projects board with the corresponding backlog entries and references to the gap identified in the Sept. 22–26 testing plan.
2026-09-21 Fix Arduino CI compile workflow
    Corrected the YAML indentation in the lint workflow and updated each Arduino/ESP32 compile step to target the concrete .ino files, enable warnings, and add DEBUG flags for the Uno build. Added a brief analysis document summarizing the root cause and the fixes.
2026-09-21 Fix Arduino CI workflow setup
    Update the GitHub Actions Arduino workflow to use the v2 setup action and overwrite the CLI config safely. Compile the specific .ino files instead of directories, keep warnings enabled, and remove the manual DEBUG build flag for the Uno target. Also remove the obsolete Arduino CLI analysis document from the repo.
2026-09-23 Add electrical diagram assets
    This commit adds the electrical diagram documentation files in both PNG and PPTX formats under docs/fluxogramas. These assets provide the project’s visual reference for the diagram in editable and rendered forms.
2026-09-23 docs: atualiza documentação com progresso da semana 6 (22-23/09) - Semana 6 (22-23/09): soldagem, diagrama elétrico e montagem MDF
    ### Progresso de bancada (22-23/09)
    **✅ Bloco 1 — Soldagem IRF520 (B/C) concluída:**
    - Placas de passagem dos drivers IRF520 (esteiras B e C) soldadas com sucesso
    - Teste de continuidade elétrica (multímetro) aprovado: VCC/GND, resistência > 100kΩ
    - Testes funcionais (PWM + motores) agendados para 23/09
    **✅ Bloco 2 — Diagrama elétrico publicado:**
    - Diagrama completo em docs/fluxogramas/Diagrama elétrico.png (PNG + PPTX editável)
    - Cobre Arduino, ESP32, 3× IRF520, 6× TCRT5000, LCD I²C, motor 28BYJ-48, alimentação 12V/5V
    - Gap 'Diagrama e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
2026-09-23 Disable TLS for local MQTT broker
    The ESP32 MQTT gateway was configured for HiveMQ Cloud with TLS enabled. This change disables TLS in gateway_mqtt.ino so it connects to a local Mosquitto broker instead, avoiding cloud certificate requirements during local development and testing.
    [gateway_mqtt.ino]
2026-09-24 Document bench issues and test updates
    This commit adds troubleshooting notes for the recurring MQTT rc=-2 cloud firewall issue and the B/C conveyor power loss after IRF520 soldering. It also updates the changelog, weekly test plan, and validation docs to reflect the new findings, mitigation steps, and status tracking for the 22–23/09 bench runs.
2026-09-25 Add MQTT TLS diagnostics sketch
    Add a standalone ESP32 sketch and README for diagnosing Wi‑Fi, DNS, TCP/TLS, and MQTT connectivity without modifying the production gateway. The sketch reuses the shared secrets.h file, supports both local Mosquitto and HiveMQ Cloud, logs PubSubClient rc errors, and documents how to interpret common broker failures.
    [test_mqtt_cloud.ino]
2026-09-28 Add test plan: Week 7 (28 Sep–02 Oct 2026)
    Add Week 7 test roteiro at docs/testes/roteiros/semana_07_28_setembro_a_02_outubro.md. Documents objectives, procedures and checklists for 28/09–02/10/2026 covering HiveMQ Cloud validation via 4G hotspot (rc=-2 troubleshooting), IRF520 B/C power diagnostics, three-esteira burn-in, MDF finishing, and documentation/cards tasks. Includes step-by-step test procedures, expected results, acceptance criteria, schedule and references.
2026-09-28 Documenta Semana 7 e reorganiza cards
    Atualiza o CHANGELOG com o roteiro da Semana 7 (28/09–02/10), cobrindo diagnóstico do rc=-2, validação de potência IRF520, burn-in, acabamento mecânico e documentação. Remove os templates antigos de comentários dos cards e adiciona um arquivo consolidado para os cards #21–#25, alinhando o backlog e os próximos passos de documentação/processo.
2026-09-29 Record HiveMQ validation; enable TLS
    Update docs to record successful HiveMQ Cloud validation (Beckhoff_Guest + hotspot 4G), rename the week-07 test roteiro, and document the hotspot misconfiguration as the root cause rather than only a corporate firewall. Update troubleshooting, changelog and cards to reflect results. Add esp32/test_mqtt_cloud/secrets.h.example to .gitignore. Enable TLS (USE_TLS = true) in esp32/gateway_mqtt/gateway_mqtt.ino and esp32/test_mqtt_cloud/test_mqtt_cloud.ino to target HiveMQ Cloud.
2026-09-29 docs: plano de implementação da arquitetura 3D (12 tarefas)
2026-09-29 docs: plano — Task 13 (Socket.IO sem CDN)
2026-09-29 docs: plano — portas de teste dedicadas (3100/3101)
2026-09-29 test: E2E de fumaça dos botões (linha de base, Playwright)
2026-09-29 feat(arquitetura): lógica pura de status das conexões
2026-09-29 feat(frontend): rota #/arquitetura, socket compartilhado e ligação protegida dos botões
2026-09-29 feat(frontend): seletor de vistas em destaque e atalhos para a arquitetura
2026-09-29 fix(frontend): remove cerca markdown do CSS, alvos de toque dos atalhos e teste de layout
2026-09-29 feat(frontend): ícones SVG nos botões, ajuda de desabilitado e contraste de --muted
2026-09-29 feat(arquitetura): coletor de sinais e LED de conexões na tecla ARC
2026-09-29 Fix doc links and add backlog cards
    This commit fixes relative links in the integration and MQTT documentation and adds backlog/card notes under docs/cards_comments for BOM, deployment guide, firmware versioning, historical telemetry, and automated E2E testing. The new documents capture objectives, acceptance criteria, dependencies, and execution plans for future documentation and tooling work.
2026-09-29 Update BOM card template status and priority
2026-09-29 feat(arquitetura): seleção, painel de detalhes e navegação por teclado
2026-09-29 feat(arquitetura): fallback 2D sem WebGL e testes de resiliência dos botões
2026-09-29 fix(frontend): cliente Socket.IO servido localmente (botões não dependem do CDN)
2026-09-29 fix(arquitetura): visão geral enquadrada na proporção do palco
    c.enquadrarGeral() busca (binária) a menor distância em que corpos,
    anéis, hardware e as placas cabem no palco sem cair sob os controles
    ou a legenda, com elevação de 50°. No retrato (proporção < 0,9) gira
    o azimute em 90° quando isso reduz a distância em mais de 15%.
    Ajusta maxDistance e a névoa à distância obtida, reenquadra ao
    redimensionar enquanto em visão geral e é usado na pose inicial, no
    botão "Visão geral" e no Esc/fechar painel. Novo teste E2E
    enquadramento.spec.mjs em 1366, 1920 e 375 px.
2026-09-29 fix(arquitetura): foco por Tab não rola a camada de rótulos
    Zera scrollLeft/scrollTop da camada CSS2D e do palco quando o
    navegador rola para mostrar uma placa focada fora da tela, e leva a
    câmera até o nó (sem abrir o painel). Teste E2E no enquadramento.spec.
2026-09-29 fix(arquitetura): alvos de toque ≥ 44 px na vista de arquitetura
    .arq-btn, .arq-check e .arq-link-enlace passam a 44 px de altura
    mínima (também no desktop: o painel cresce ~50 px e o enquadramento
    da visão geral já o considera). As placas .arq-rotulo ganham área de
    toque invisível (::after) de 46 px sem mudar o visual; 8 px entre
    alvos no grupo de câmera e na lista de conexões. mobile.spec confere
    os controles abertos.
2026-09-29 chore(arquitetura): ajustes menores da revisão final
    - index.html: comentário da vista cita arquitetura-vista.js (entrada)
    e arquitetura3d.js (sob demanda).
    - arquitetura-vista.js: comentários sem referência ao plano; placa do
    nó montada com createElement/textContent (sem innerHTML).
    - arquitetura3d.js: etiqueta de hardware em dois spans (sem innerHTML).
    - diagrama3d.js: comentário corrigido (lista fixa de vistas).
    - arquitetura-sinais.js: após 404 (simulador) não consulta /api/status
    de novo; teste unitário novo.
    - arquitetura-fallback.js: aria-label do SVG simplificado.
    - arquitetura.spec 5c: coleta e confere erros de console.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
2026-09-29 test: ajuda de desabilitado verificada de forma determinística (sem corrida de tempo)
2026-09-29 Add frontend dashboard documentation
    This change adds a dedicated frontend guide for the Data Flow Inventory dashboard. It documents the dashboard features, navigation, repository structure, live Socket.IO flow, simulator and hardware setup, and verification steps for local testing.
2026-09-30 docs: spec da telemetria histórica de performance (Prometheus + Grafana)
2026-09-30 docs: plano de implementação da telemetria histórica (12 tarefas)
2026-09-30 feat(metricas): núcleo de métricas Prometheus (conexão, gateway, eventos, estoque, esteiras)
2026-09-30 feat(metricas): casamento comando → confirmação do gateway e métricas de comando
2026-09-30 feat(metricas): middleware HTTP com tempo de resposta da API por rota
2026-09-30 feat(metricas): GET /metrics e ganchos de conexão, mensagens e API no server.js
2026-09-30 feat(metricas): ganchos do fluxo de comandos (ack, confirmação, recusas e sem resposta)
2026-09-30 test(metricas): endurece o harness contra carga (timeouts, retry de porta, limpeza)
2026-09-30 fix(observabilidade): stat de erros MQTT mostra 0 sem erros (or vector(0))
2026-09-30 docs(observabilidade): ARCHITECTURE, CHANGELOG e job de CI para as métricas
2026-09-30 docs(observabilidade): precisao dos rotulos, estoque e status de validacao
2026-10-01 docs(deployment): corrige comando de teste, USE_TLS e detalhes de setup
2026-10-01 ci: instala bibliotecas Arduino e cria secrets.h de exemplo no job arduino-compile
2026-10-01 Include Data Flow Architecture image in README
    Added an image of the Data Flow Architecture to the README.
2026-10-02 fix(firmware): timeout de entrega 12,5 s e confirmacao por passagem no sensor de juncao
    [data_flow_inventory.ino]
2026-10-02 feat(firmware): PWM proprio para a esteira C (VELOCIDADE_ESTEIRA_A/B/C)
2026-10-02 docs: documenta compilacao local do firmware com arduino-cli e pendencias de bancada
2026-10-02 docs(testes): corrige caracteres corrompidos (mojibake UTF-8) no plano de testes
2026-10-02 feat: estoque inicial de 15 pecas por tipo (firmware Uno e simulador)
2026-10-02 docs(grafana): escala do painel de estoque ate 15 pecas
2026-10-02 docs: spec de divulgacao do projeto
2026-10-02 docs: plano de implementacao da divulgacao do projeto
2026-10-02 docs: normaliza o LICENSE (MIT) para reconhecimento pelo GitHub
2026-10-02 docs: formularios de issue, template de PR, codigo de conduta e politica de seguranca
2026-10-02 docs(contributing): move a secao 7 para antes do rodape
2026-10-02 docs: plano de divulgacao organica do projeto
2026-10-02 docs(changelog): divulgacao, README reorganizado e arquivos de comunidade
2026-10-02 fix(firmware): reverte timeout, estoque e confirmacao por passagem; mantem PWM por esteira
    [data_flow_inventory.ino]
2026-10-02 fix(firmware): reaplica timeout 12,5 s, passagem e estoque 15; corrige LCD em ERRO, publicacao escalonada e status das esteiras
    [data_flow_inventory.ino]
2026-10-03 fix(firmware): filtro da juncao, estados publicados na ordem certa, parser estrito, buffer do ESP32 e docs alinhadas
    [data_flow_inventory.ino, gateway_mqtt.ino]
2026-10-03 docs: plano de implementacao do firmware Uno v3
2026-10-03 feat(firmware): filtro de entrada e causa do reset em logica pura
    [causa_reset.cpp, causa_reset.h, filtro_entrada.cpp, filtro_entrada.h, teste_filtro_reset.cpp]
2026-10-03 feat(firmware): supervisor de entrega por marcos (partida, transito, saida)
2026-10-03 fix(firmware): ocupouEm marcado apos a leitura de millis nao confirma passagem
    [supervisor_entrega.cpp, teste_supervisor.cpp]
2026-10-03 feat(firmware): maquina de estados com checagem previa e debito so na confirmacao
2026-10-03 fix(firmware): propriedade de debito por varredura, juncao ocupada antes da partida nao confirma
    [fsm.h, supervisor_entrega.cpp, teste_fsm.cpp, teste_supervisor.cpp]
2026-10-03 fix(firmware): LCD com I2C preso desliga o LCD, watchdog para os motores, saida segura a cada ciclo
    [data_flow_inventory.ino, diagnostico.cpp, lcd.cpp, motores.cpp, motores.h, sensores.cpp]
2026-10-03 docs(firmware): marcos, novos erros, campos opcionais, CI e roteiro de bancada da v3.0
2026-10-03 docs(firmware): roteiro com peca no topo nos passos de falha e notas de versao
2026-10-03 fix(firmware): juncao ocupada no ciclo da partida vai para erro sem ligar o motor
    Um pulso que comecava antes da partida e terminava depois confirmava a
    entrega pelo maiorPulsoMs. O ACIONANDO_ESTEIRA repete a checagem da
    juncao antes de zerar a captura e iniciar o supervisor.
    [fsm.cpp, teste_fsm.cpp]
2026-10-03 fix(firmware): energizacao com PORF e BORF sai como energia, nao brownout
    [causa_reset.cpp, teste_filtro_reset.cpp]
2026-10-03 fix(firmware): captura da juncao descarta pulso anterior a partida e limita rajada de PCINT
    - sensorJuncaoZerar marca o pulso em curso; ao liberar, a largura dele
    nao entra em maiorPulsoMs (R1).
    - Mais de 8 bordas de uma juncao no mesmo millis() desligam a PCINT dela;
    sensoresAmostrar ressincroniza o nivel e religa. Uma rajada do LM393
    no limiar nao deixa mais o loop e a WDT_vect sem CPU.
    [sensores.cpp]
2026-10-03 fix(firmware): watchdog em volta do lcdIniciar, kick fora do tempo da serial e static_assert dos prazos
    - setup alimenta o watchdog antes e depois de lcdIniciar; lcdIniciar limpa
    a flag de timeout do I2C antes do init (sondagem de 0x27 sem resposta
    desligava a toa um LCD em 0x3F).
    - motoresAplicar roda de novo depois da serial e do LCD.
    - static_assert: prazoPartidaMs <= timeoutMs nas tres esteiras.
    [data_flow_inventory.ino, lcd.cpp]
2026-10-03 ci(firmware): fixa LiquidCrystal I2C 1.1.2 e lista firmware-logica nos checks obrigatorios
2026-10-03 docs(firmware): juncao ocupada na partida, limitador de rajada e causa do reset
2026-10-04 test(frontend): alvo de 44 px aceita arredondamento de subpixel do boundingBox
2026-10-05 Atualiza status da bancada e roteiro da Semana 8
    Atualiza a documentação com a correção do diagnóstico do hardware: as esteiras B/C voltaram a funcionar após a troca do módulo IRF520 e do motor da C, com a C usando provisoriamente o módulo da A. Também registra a validação do firmware anterior e a nova rotina de testes da Semana 8 para a v3.0 em bancada, além de alinhar README, CHANGELOG, DEPLOYMENT e os roteiros de testes.
2026-10-06 Documenta arquitetura e testes do projeto
    Atualiza a documentação principal do repositório para refletir a nova estrutura do firmware Arduino/ESP32, os módulos de teste e os documentos de arquitetura, frontend e divulgação. Também registra no changelog a expansão da cobertura E2E do dashboard, incluindo os novos casos de comandos recusados, sem estoque, reconexão e API status. A nota menciona que uma execução parcial registrou 31 testes passando com 2 falhas, e que a suíte completa ainda não foi revalidada após a última correção.
2026-10-07 test(e2e): contagens relativas ao histórico e espera do rate limit após o reset
    - E2E3 (sistema ocupado): o simulador é compartilhado entre os specs e reenvia
    os últimos 10 eventos em estado_inicial; as contagens de 'Peça A solicitada'
    e 'Peça A entregue' passam a ser relativas ao histórico antes do pedido.
    - E2E3 (sem_estoque): o pedido de B saía < 500 ms depois do reset no mesmo
    socket e era recusado pelo rate limit; espera INTERVALO_COMANDO_MS + 100 ms.
2026-10-07 fix(deps): npm audit fix para proxy-addr, engine.io e ip-address
    Avisos publicados depois do último CI verde derrubaram o job npm-audit
    (--audit-level=critical). Só versões de correção nos lockfiles; nenhum
    package.json mudou:
    - proxy-addr 2.0.7 -> 2.0.8 (crítico, GHSA-jqcg-44mw-7w3h; via express)
    - engine.io 6.6.9 -> 6.6.11 (alto, GHSA-2gc4-cqfq-p2gv; via socket.io)
    - ip-address -> 10.7.3 (moderado; via socks/mqtt)
    - simulator: socket.io-adapter 6.15.3 -> 6.16.0 (puxado pelo engine.io)
2026-10-07 test(e2e): sistema ocupado confirma o pedido na aba que pediu
    No CI, a segunda aba às vezes perde o WebSocket enquanto termina de carregar
    a cena 3D (renderização por software) e reconecta logo depois; como o
    dashboard não repete o histórico numa reconexão, o 'Peça A solicitada'
    emitido nesse intervalo nunca aparecia nela. A confirmação passa a ser lida
    na aba principal; a segunda aba só precisa do estado ocupado (que chega por
    'status' ou pelo 'estado_inicial' da reconexão) e da recusa do pedido de B.
2026-10-08 docs(readme): link para a página de apresentação do projeto
2026-10-08 docs(artigo): projeto de pesquisa atualizado com o histórico até 08/10
    Sem mudar a estrutura de tópicos: capa com orientadores, figuras 2 e 3 atuais,
    texto do código (firmware v3.0), itens da seção de evolução atualizados e
    novos (n a u), Tabela 1 com 20 decisões e conclusões com os próximos passos.
2026-10-13 feat(firmware): registro comentado do separador (roda giratória) na v3.0
    Devolve ao firmware, como comentário, o código do separador do v2.x
    (28BYJ-48 + ULN2003, pinos 5 a 8): src/hw/separador.h/.cpp, bloco em
    config.h e chamadas no .ino. Nada é compilado: o Uno mantém 14510 bytes de
    flash e 951 de RAM. Sem testes nesta semana.
    Registra o aviso de que Stepper::step() bloqueia (~2 s a 120°) contra o
    watchdog de 2 s. Corrige a documentação que dizia que o rascunho existia só
    no histórico do git.
2026-10-13 feat(firmware): separador sem bloqueio, para o watchdog não reiniciar o Uno
    Stepper::step() é uma espera ativa: a 10 RPM, 120° levam ~2 s, o mesmo do
    watchdog de 2 s. A camada de hardware registrada (ainda comentada) agora dá
    no máximo 1 passo por volta do loop(), nunca em rajada, e solta as bobinas
    depois de parada e no ISR do watchdog.
    Nova lógica pura src/logica/plano_separador.* com 10 testes no PC (suíte de
    43 para 53). Ainda não é usada pelo firmware: o Uno segue com os mesmos 14510
    bytes de flash e 951 de RAM. Com tudo descomentado (só compilação), compila
    sem avisos em 50% da flash e 48% da RAM. Giro nunca testado em hardware.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
2026-10-13 Roteiros de teste e atualização da documentação (Atualizar validação e planejamento de testes)
    Documenta a validação em bancada do firmware Uno v3.0, separando resultados confirmados das pendências do Bloco 3 e do separador. Também adiciona os roteiros das semanas 9 e 10, replaneja a execução de A+B+C/calibração, e ajusta referências na arquitetura, README, guia de integração e changelog para refletir o estado atual com evidências e cautela.
    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
2026-10-16 Apenas mudança visual de um dos elementos do diagrama 3D (Reorienta separador no diagrama 3D)
    Exibe o separador como um cilindro vertical apoiado na bancada e atualiza a terminologia no SVG de fallback e na documentação.
    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
2026-10-16 Nova imagem do simulador com o formato certo do separador e nova quantidade de estoque inicial (Update DataFlowInventory image)
    Replace the existing `img/DataFlowInventory.png` asset with an updated version.
    Commity e era isso!
2026-10-18 Calibração dos motores para os testes do dia 18/10
    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
2026-10-18 fix(firmware): LCD acha o módulo em qualquer endereço e se recupera de quedas
    Na bancada o display mostra só quadrados pretos e o inicio traz lcd:false: o
    Uno não recebeu resposta do módulo I2C em 0x27 nem 0x3F. A revisão achou que a
    sondagem era uma tentativa só e só em dois endereços, e que um único timeout
    de I2C desligava o LCD para sempre.
    - Varre o barramento (0x08-0x77) e usa o módulo em 0x20-0x27 ou 0x38-0x3F;
    com o barramento preso, desiste no primeiro timeout.
    - Se o LCD sumir, tenta religá-lo só com o sistema parado (a cada 5 s, dobrando
    até 60 s). O watchdog é alimentado antes e depois do init (~1 s).
    - status ganha lcd_end, i2c_n e lcd_quedas (opcionais; pior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
2026-10-18 feat(firmware): separador ativo, sem bloqueio, nos pinos 5 a 8 (rotação na entrega desligada)
    Ativa o separador (28BYJ-48 + ULN2003, IN1..IN4 em D5..D8) sobre o plano de giro
    sem bloqueio (no máximo 1 passo por volta do loop, bobinas soltas parado e no
    ISR do watchdog). Por padrão só gira pelo comando de bancada CMD:SEP:A|B|C|0 pela
    USB; a rotação automática na entrega fica desligada (SEPARADOR_NA_ENTREGA 0) até
    validar a roda isolada, como pedem os roteiros das Semanas 9 e 10.
    - Passos por volta 2038 (engrenagem 63,68:1), não 2048, para a roda não desalinhar.
    - Angulos (SEPARADOR_GRAUS_*) e sentido (SEPARADOR_INVERTER_SENTIDO) configuráveis.
    - CI instala a biblioteca Stepper@1.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
2026-10-18 feat(firmware): separador se prepara de acordo com a peça pedida
    A roda parte assim que a checagem prévia aprova o pedido (ACIONANDO_ESTEIRA),
    antes de o motor ligar e bem antes da confirmação da entrega, e fica no
    compartimento depois dela. Pedido recusado não gira a roda.
    Lógica pura em src/logica/separador_auto.*, por nível (sem fila). Em config.h,
    SEPARADOR_AUTOMATICO (padrão 1) substitui SEPARADOR_NA_ENTREGA e
    SEPARADOR_ESPERA_APOS_ENTREGA_MS (padrão 0) atrasa a troca de compartimento se
    pedidos seguidos puderem tirar a roda do lugar antes de a peça anterior cair.
    Testes no PC: 78 -> 84, inclusive com a FSM real. Uno: 17350 B de flash (53%) e
    1021 B de RAM (49%). Modo autom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
2026-10-18 Documenta calibração e pendências de bancada
    Atualiza README, arquitetura e roteiros com os valores PWM/kick por esteira, registrando a calibração como relato sem inventar medições ou aprovações. Documenta também as pendências do Bloco 3, do LCD e do separador, e inclui um handoff com o contexto técnico do dia.
    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
2026-10-19 Roteiros mais recentes (Atualiza roteiros das semanas 9 e 10)
    Adiciona resumos de status e critérios de saída aos roteiros das semanas 9 e 10 e atualiza o README com links para as etapas planejadas.
    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
2026-10-21 Bancada 20/10 (Registrar testes e calibração das esteiras)
    Marca como concluídos os ensaios da Semana 10 e registra medições e observações das esteiras A, B e C, incluindo a nova calibração de 20/10.
    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
2026-10-21 feat(frontend): o cilindro do separador no diagrama reage à ativação
    O cilindro (disco liso) ganha 3 compartimentos (A, B, C, nas cores das peças),
    um anel que acende enquanto gira e um marcador fixo no ponto de recebimento, e
    gira até a peça pedida a 60°/s (10 RPM) pelo caminho mais curto, como a roda
    real. O SVG de reserva (sem WebGL) ganha a mesma roda.
    frontend/js/separador.js aplica ao status que o dashboard já recebe a mesma regra
    do firmware (separador_auto): a roda parte quando a checagem prévia aprova o
    pedido (ACIONANDO_ESTEIRA), segue na entrega e fica no compartimento até o pedido
    seguinte; pedido recusado não a move e o evento inicio a devolve ao neutro.
    Funciona igu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
2026-10-22 Increase conveyor B kick PWM
    Raise the kick PWM setting for conveyor B from 130 to 180.
2026-10-23 Ta acabando (Atualiza plano da bancada para a Semana 11)
    Registra a validação das esteiras e os ajustes de PWM/kick da Semana 10, além de documentar a montagem final, os testes das peças 3D e a integração total planejados para a Semana 11. Inclui também o roteiro de atualização dos cards do GitHub Projects e suas evidências.
    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
2026-10-23 docs(readme): sincroniza com a calibração da Semana 10, o separador e a Semana 11
    Status de validação de 23/10, roda giratória integrada ao firmware,
    PWM/kick atuais por esteira, pinagem do separador (5 a 8), LCD com
    endereço automático, vista #/arquitetura, bibliotecas do Uno e
    próximos passos da última bancada. Estrutura e seções mantidas.
2026-10-23 test(e2e): espera o rate limit antes do reset no cenário sem_estoque
    O simulador entra em ERRO ~300 ms após o pedido (DELAY_VERIFICACAO) e
    recusa comandos com menos de 500 ms no mesmo socket; o clique no Reset
    logo após o ERRO podia ser recusado e o sistema ficava em ERRO. Mesmo
    padrão de e91027e.
2026-10-26 Add custom SVG favicon
    Add a Data Flow Inventory icon and link it as the browser favicon and Apple touch icon.
2026-10-27 feat(firmware): display OLED 0,96" I2C (SSD1306) no lugar do LCD 16x2
    O LCD 16x2 não respondia no I2C (i2c_n 0, falha elétrica) e será trocado
    por um OLED 128x64 SSD1306. Layout A: a mesma tela de 2 linhas x 16
    colunas, em fonte X11fixed7x14 com 2 px entre letras (16 colunas = 128 px);
    linha 1 nas páginas 0-1 (faixa amarela dos módulos bicolores), linha 2
    nas páginas 4-5.
    - Biblioteca SSD1306Ascii 1.3.5: escreve direto no display, sem imagem da
    tela na RAM (a Adafruit_SSD1306 pediria 1024 bytes; o firmware usa 1021
    de 2048). RAM igual à de antes; flash 53% -> 59% (fonte).
    - Varredura procura 0x3C/0x3D (antes 0x20-0x27 e 0x38-0x3F, que incluía
    o 0x3C e confundiria o OLED com um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
2026-10-27 docs: troca do LCD 16x2 pelo display OLED 0,96" I2C (SSD1306)
    Sincroniza a documentação com o PR #68. README (árvore, estados,
    diagrama, materiais, pinos, bibliotecas e próximas validações),
    ARCHITECTURE (bibliotecas, campos do status, robustez e hardware),
    CI-CD, DEPLOYMENT, plano de testes (B3 com o reteste do OLED; registro
    de 18/08 mantido), roteiro da Semana 11, guia do separador, card do BOM,
    CHANGELOG e projeto de pesquisa (só os parágrafos do estado atual e o
    item p na lista de evolução). O diagrama elétrico não desenha o display,
    então não mudou; o README deixa isso explícito.
2026-10-28 feat(firmware): faixa de ícones dos estados da FSM no display OLED
    Os 16 px de baixo do OLED ganham um ícone por estado da FSM (ampulheta,
    lupa, raio, caixa na esteira, alerta), o do estado atual invertido. A
    linha 2 sobe para as páginas 3-4; o texto continua com 2 linhas x 16
    colunas.
    - Ícones como uma fonte de 5 glifos 20x16 na flash (src/hw/icones_fsm.h,
    206 B, gerada das mesmas artes da prévia), desenhada pela SSD1306Ascii
    com setInvertMode.
    - lcdIcones() só redesenha quando o estado muda, e só os 2 ícones que
    trocam; a faixa inteira depois de iniciar/religar. Sem animação, para
    não escrever no I2C com o motor ligado. Timeout cai na recuperação.
    - iconeTela() (lógi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
2026-10-29 docs(testes): Semana 11 — esteira A montada na base com entregas
    Roteiro da Semana 11: atualização de estado de 29/10 (sem atividade de
    bancada em 26-27/10; em 28/10 a esteira A foi montada na base e algumas
    entregas foram testadas com sucesso), status por item e por dia, linha
    da A na tabela de registro e risco de prazo para 29-30/10. Tempos e
    ciclos ficam "a registrar" (não informados).
    Plano de testes: situação de validação e pendências de 29/10, linha M2
    no registro de resultados e observações de 28/10.
2026-10-29 docs(testes): esteira A na base aprovada (10 entregas, 4650-5000 ms)
    Dados de 28/10 informados pela equipe: 10 entregas sem falha, tempo de
    4650 a 5000 ms (igual à calibração de 21/10), peça improvisada (a
    impressa em 3D ainda não foi verificada), sem mudança de código; o
    display OLED ainda não chegou.
2026-10-29 docs: corrige links quebrados e valores desatualizados
    Correções imediatas da análise da documentação de 29/10:
    - 8 links quebrados pela remoção de separador_bancada.md e
    firmware_uno_v3_validacao.md (e9d29b4): roteiros históricos e o guia
    do board apontam para a última versão desses arquivos (4c8ae6c); o
    README e o ARCHITECTURE apontam para onde a informação vive hoje
    (roteiro da Semana 11 e roteiro da Semana 8).
    - README: 84 -> 97 testes do firmware e status de validação de 29/10
    (esteira A na base).
    - ARCHITECTURE: kick da B 130 -> 180 ms e PWM da A 225 -> 245; a nota
    "nada disso foi validado em bancada" vira o registro da validação de
    13/10.
    Co-Authored-By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
2026-10-29 docs(changelog): entradas reagrupadas em marcos fechados
    A seção [Não publicado] acumulava 54 entradas desde agosto, com
    Alterado repetido 7 vezes e sem ordem de data. Agora: [Não publicado]
    só com a Semana 11 (em andamento) e os Marcos 1 a 5 fechados, cada um
    com uma seção de cada tipo e entradas da mais nova para a mais velha.
    Texto das entradas inalterado (conferido por script). Cabeçalho explica
    como registrar e como fechar um marco.
2026-10-29 docs(testes): resultados de bancada separados do plano de testes
    O plano_de_testes.md misturava procedimentos, a tabela de resultados e
    um diário de observações fora de ordem (16/09 depois de 22/09, blocos de
    29/09 e 13/10 soltos no meio de rascunhos de cards).
    - docs/testes/resultados.md (novo): fonte única do estado da bancada,
    com estado atual, registro de resultados e diário em ordem cronológica
    (os bullets soltos foram agrupados por data).
    - plano_de_testes.md: só a tabela de testes e os procedimentos, com um
    link para os resultados.
    - Rascunhos de comentários de cards de setembro, que estavam no plano:
    docs/cards_comments/sugestoes_cards_setembro_2026.md, como arquivo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
2026-10-29 ci: verifica links e âncoras da documentação
    Novo job docs-links roda scripts/verificar-links.py: falha se um link
    relativo de um .md versionado aponta para arquivo inexistente ou para
    uma âncora (#secao) que não existe no destino, com o mesmo cálculo de
    âncora do GitHub. Links externos não são verificados (dependem da rede).
    Testado com um link quebrado de propósito.
    Corrige as 2 âncoras quebradas que ele achou no FRONTEND.md (título
    "Como Visualizar" que tinha sumido e item de sumário sem seção).
    Closes #39
2026-10-29 docs: status em um só lugar, sem copiar números que mudam
    - README: o parágrafo de status e as seções de próximos passos (com
    datas, que desatualizavam a cada semana) viram links para
    docs/testes/resultados.md, os roteiros, o GitHub Project e o
    CHANGELOG. Sem contagem de testes nem PWM/kick por esteira: os valores
    ficam em PARAM_ESTEIRA_A/B/C (config.h).
    - ARCHITECTURE: mesmo tratamento para PWM/kick; resultados.md na lista
    de documentos.
    - INTEGRATION_GUIDE e roteiro da Semana 11: registrar resultados em
    resultados.md.
    - CI-CD: documenta o job docs-links.
    - Pasta docs/testes/validações -> docs/testes/validacoes (o acento
    quebrava scripts e o git ls-files); referências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
2026-10-29 docs: cards com uma fonte só e mapa de onde registrar o quê
    - Guia do board (board_github_projects.md, 395 -> 159 linhas): fica só
    com as regras. O catálogo de cards de agosto/setembro (seções 2 a 5,
    com numeração que não batia com as issues) vai para
    docs/cards_comments/catalogo_cards_setembro_2026.md. Regras alinhadas
    ao board real: sem a coluna "In Review" (o PR aberto faz esse papel),
    Área preenchida a partir do label area:*, Done automático pelo
    Closes #N, workflows a ligar (auto-add) e resultados em resultados.md.
    - docs/cards_comments/README.md: a pasta vira arquivo; a fonte do
    andamento são as issues do GitHub Project.
    - Template de PR com "Closes #" e CONTR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
2026-10-29 test(metrics): procura a telemetria no marco do CHANGELOG, não só em [Não publicado]
    O teste exigia a entrada da telemetria histórica dentro de
    "## [Não publicado]" (título exato). Com o CHANGELOG organizado por
    marcos, a entrada fica no Marco 3 e o título de [Não publicado] ganhou
    um subtítulo: o split devolvia undefined (TypeError). Agora o teste
    acha o marco que contém a entrada e confere, na própria entrada,
    GET /metrics e observability/README.md, e que ela está num marco (não
    numa seção de commit antiga).
2026-11-03 docs(testes): Semana 11 encerrada (esteira B na base) e roteiro da Semana 12
    - Semana 11: esteira B montada na base e testada em 29-30/10; 10
    entregas com A e B, 5000-6000 ms (aceitável). Status final por item e
    por dia; o que não foi feito aparece como transferido.
    - resultados.md: estado atual de 03/11, linha M2 com A e B, diário de
    29-30/10 e pendências da Semana 12.
    - Roteiro da Semana 12 (03-06/11; 02/11 feriado): esteira C na base,
    tempos por esteira (5000-6000 ms com A e B contra 4650-5000 ms da A
    isolada), integração total A+B+C, peças 3D e separador automático,
    reteste do display OLED.
    - CHANGELOG: a Semana 11 vira o Marco 6; nova [Não publicado] para a
    Semana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
2026-11-03 docs(testes): 10 entregas de cada esteira (A e B); display recebido; peças 3D ainda não usadas
    Confirmações da equipe em 03/11: foram 10 entregas de cada esteira (A e
    B) na base, 5000-6000 ms; o display OLED chegou e será testado na
    Semana 12; as peças impressas em 3D ainda não foram usadas (integração
    com elas na Semana 12).
2026-11-03 docs(testes): esteira C integrada na base; diagnóstico do giro curto do separador
    Semana 12, 03/11: a esteira C foi integrada com sucesso à base (número
    de entregas e tempos a registrar). O separador se move, mas aparenta
    girar menos que o esperado: o roteiro ganha um diagnóstico em 3 passos
    (com e sem a roda, com marca de referência) que separa passos perdidos
    sob carga, passos por volta errados e posição dos compartimentos, com o
    ajuste de cada caso. resultados.md e CHANGELOG atualizados.
2026-11-04 Double separator step-count constants
    Update the separator wheel and Stepper library revolution values from 2038/2048 to 4076/4096.
2026-11-04 docs: glossário de termos do projeto
    Novo docs/GLOSSARIO.md com FSM, LWT, retained, QoS, broker, gateway,
    IRF520, PWM e TCRT5000 (cada um em até três linhas, ligado ao projeto).
    Linkado no README, no mapa docs/README.md e registrado no CHANGELOG.
    Closes #37
2026-11-05 docs(testes): esteira C aprovada (10 entregas, 4103-5069 ms), OLED aprovado, separador gira metade
    - Esteira C na base: 10 entregas, 4103-5069 ms (03/11); A, B e C
    montadas na base e aprovadas (linha M2).
    - Display OLED: reteste B3 aprovado em 03/11.
    - Separador: gira cerca de metade do esperado, também com RPM 5
    (c54776c) e fonte de 12 V dedicada. Fator fixo de 2 independente da
    velocidade aponta para passos por volta ou transmissão eixo -> roda;
    o roteiro ganha o teste do eixo x roda com o ajuste de cada caso.
2026-11-05 docs: separador corrigido (4076 passos), tempos por esteira e acabamento
    - Separador (04/11): com 4076 passos por volta (99786b7) a volta fecha
    na marca e a roda chega a tempo de receber as peças. Origem física do
    fator 2 não identificada: o valor fica registrado como medido.
    - Tempos por esteira na base (04/11): A 5513, B 4437, C 4086 ms.
    - Roteiro da Semana 12 e resultados.md: status de 05/11 (acabamento da
    elétrica e fixação da roda em andamento; base e cabos pendentes).
    - config.h, separador.cpp, ARCHITECTURE e INTEGRATION_GUIDE deixam de
    citar 2038 como o valor em uso; teste confere os passos de A e B com
    4076, os da tabela do guia.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
2026-11-05 docs: integração A+B+C aprovada e produtos feitos à mão
    - Integração total na base: entregas consistentes, sem perda de conexão
    nem reinício do Uno ou do ESP32 (linha I1 no registro de resultados).
    - Decisão da equipe: o transporte não usará peças impressas em 3D; os
    produtos serão feitos à mão. A roda separadora impressa continua.
    README (materiais), roteiro da Semana 12 e resultados atualizados.
    - Teste do separador confirmado com SEPARADOR_RPM 10.
    Refs #65
2026-11-09 docs(testes): Semana 12 encerrada e roteiro da Semana 13 até a integração total
    - Semana 12: roda separadora fixada no motor, com giro e posições
    testados; status final por item e por dia; o que não foi concluído
    aparece como transferido.
    - Roteiro da Semana 13 (09-13/11): produtos feitos à mão, acabamento da
    elétrica, da base e dos cabos, reteste das esteiras e integração
    total do projeto.
    - resultados.md: estado de 09/11; a integração aprovada passa a ser a
    das esteiras (I1), e a integração total do projeto entra como
    pendente (I2); 5513 ms aceito como referência da esteira A.
    - Inconsistências corrigidas: motor de passo documentado como versão de
    12 V em f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
2026-11-12 docs: roda separadora na base, produtos comprados, CONIC e fotos do protótipo
    - Semana 13 (até 12/11): roda separadora montada na base; os produtos,
    que seriam feitos à mão, foram comprados prontos (falta testá-los em
    operação); integração total prevista para 13/11. Acabamento sem
    registro de conclusão.
    - Fotos do protótipo montado (10/11) renomeadas em img/prototipo/
    (prototipo-montado-frente.jpg, prototipo-montado-superior.jpg), sem
    metadados; README ganha a seção "Protótipo montado".
    - Apresentação no CONIC registrada no roteiro, nos resultados e na
    DIVULGACAO; vídeos ficam na release de mídia midia-conic-2026, fora do
    histórico do Git.
    Refs #65 · Refs #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
2026-11-13 docs(testes): teste dos produtos (12/11) e ajuste fino da roda separadora
    - 12/11: os produtos A e C nem sempre passam da esteira secundária para
    a principal (ajuste mecânico); a roda gira menos que deveria e o
    produto nem sempre cai no compartimento certo. Linha P1 (parcial) no
    registro de resultados.
    - Roteiro da Semana 13: Bloco 1b com o procedimento empírico de ajuste
    fino da roda (volta completa x5, compartimentos centrados, pedidos
    seguidos) e o ajuste de config.h para cada causa; integração total
    prevista para 13/11, já com o CX9240.
    - Mantida a marcação da equipe no Bloco 1; o item "percorre até a
    principal sem enroscar" fica como parcial (A e C intermitentes).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
2026-11-13 feat(firmware): detecta a falta de energia dos periféricos pelos sensores
    O Uno e o ESP32 seguem ligados pela USB quando a fonte do sistema é
    desligada, e os sensores sem alimentação passam todos a ler "ocupado":
    o dashboard continuava mostrando tudo OK, e um pedido saía como
    juncao_obstruida ou motor_sem_avanco.
    - Os 6 sensores ocupados juntos por 500 ms (ENERGIA_FALHA_MS), em
    qualquer estado, levam a ERRO com o erro novo sem_energia (motores
    parados; o reset recomeça a contagem). Os 3 topos ocupados são normais
    (estoque), mas as 3 junções ocupadas juntas não acontecem em operação.
    - Na entrega, uma junção de outra esteira ocupada suspende a confirmação
    por até 1 s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
2026-11-13 feat(frontend): alerta de falta de energia; simulador e E2E do erro sem_energia
    - Dashboard: faixa de alerta (#alerta-energia, role="alert") no erro
    sem_energia, também para quem abre a página depois do erro (semeada
    pelo último erro do histórico no estado_inicial); some quando o
    sistema sai de ERRO. Histórico com a causa legível.
    - Simulador: mesma regra do firmware (6 sensores ocupados, ERRO depois
    de 500 ms; reset com a fonte fora detecta de novo; entrega em curso
    para sem débito). Gatilho só para testes, com SIMULAR_FALHAS=true
    (eventos simular_falta_energia e simular_energia_volta), ligado no
    simulador da porta 3100 do Playwright.
    - E2E energia.spec.mjs (3 cenário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
2026-11-13 docs: cita o card #80 (melhoria contínua: falta de energia dos periféricos)
    CHANGELOG, ARCHITECTURE (erro sem_energia), item B4 do plano de testes e
    roteiro da Semana 13 apontam para o card da melhoria.
    Refs #80
2026-11-13 fix(simulador): suspende a entrega na queda de energia, como o firmware
    O E2E "queda no meio da entrega" falhou no CI: o simulador deixava a
    entrega seguir até o ERRO (500 ms depois do corte), e no runner lento
    ela terminava antes e debitava o estoque (13 -> 12). Na nova tentativa,
    a janela de 1,5 s de ENTREGANDO_PECA passou entre duas verificações do
    Playwright.
    - Simulador: na queda, a entrega em curso fica suspensa na hora (como a
    confirmação no firmware, SUSPEITA_ENERGIA_MS) e é retomada se a
    energia voltar antes do ERRO.
    - Teste: o corte é disparado dentro da página no exato status
    ENTREGANDO_PECA, sem depender do intervalo de verificação.
    Validado: energia.spec.mjs 5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
